ShixuanLiu9527/VUPRS-Support/fpga-support/tools/pic/image3.png

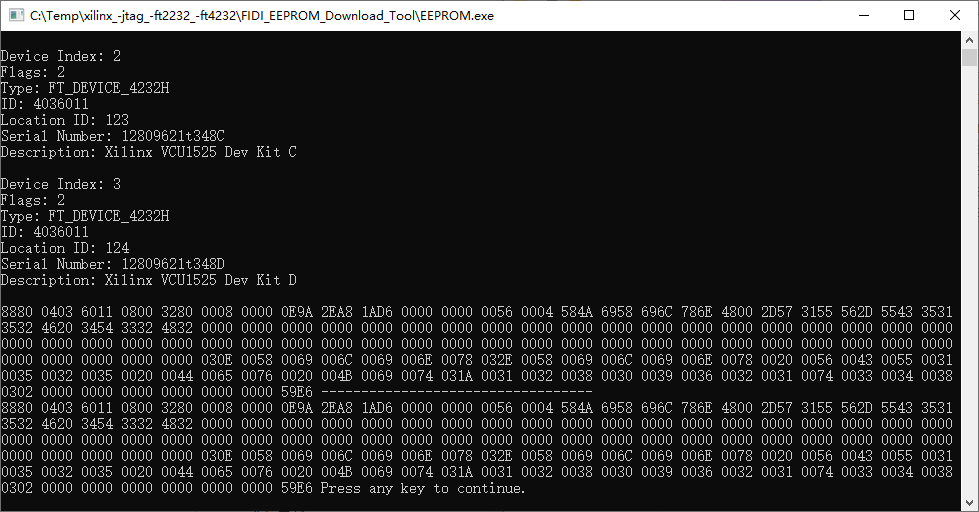
fpga-support/tools/pic/image3.png
