ShixuanLiu9527/VUPRS-Support/doc/VUPRS-Schematic.pdf

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
# Revision History

Version | Date | Author | Dsecription
V1.0 | 2025-5-15 | Shixuan Liu | First confirmation, some resistors & capacitors have been reserved.
V1.1 | 2025-7-13 | Shixuan Liu | Circuit inspection completed.

# 6223-UUD USB2 HOST3

# Debug

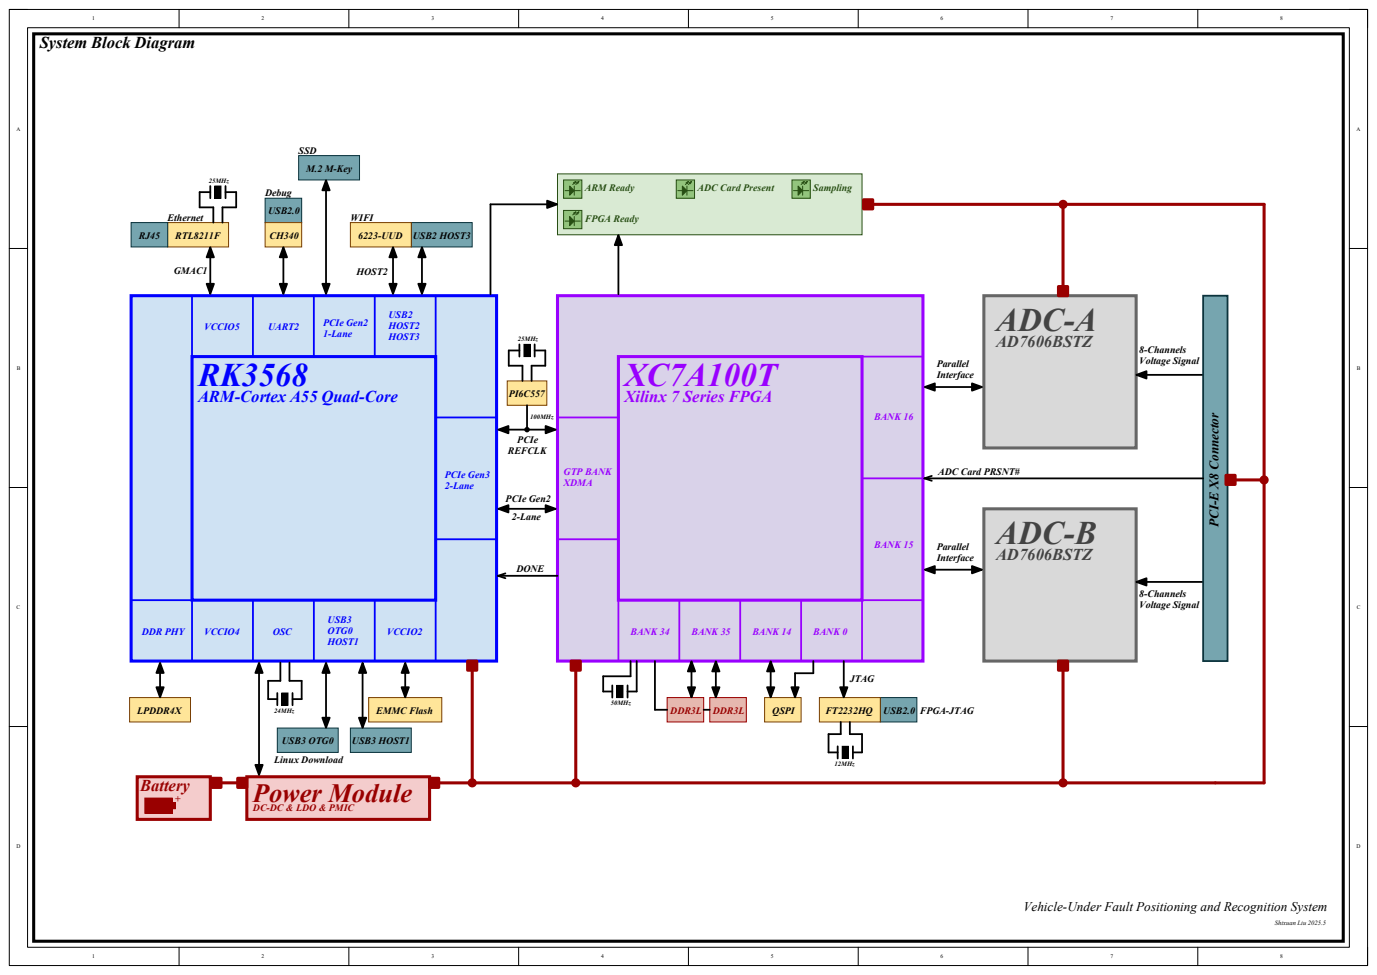
[picture p16: page 2]
ARM-Cortex A55 Quad-Core; Xilinx 7 Series FPGA; PCIe Gen3 2-Lane; GTP BANK XDMA; BANK 34; 2-Lane; Parallel Interface; BANK 16; PCIe Gen2; BANK 35; DDR3L DDR3L; 50MHz; BANK 14; BANK 0; QSPI; JTAG; USB2.0; VCCIO2; EMMC Flash; OSC; 24MHz; USB3 OTG0 HOST1; USB3 OTG0; USB3 HOST1; Linux Download; USB2 HOST2 HOST3; VCCIO4; UART2; HOST2; WIFI; AD7606BSTZ; ADC-A; BANK 15; Parallel; ADC-B; Interface; 8-Channels Voltage Signal; PCIe Gen2 1-Lane; M.2 M-Key; SSD; 100MHz; ADC Card PRSNT#; PCI⁻E X⁸ Connector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

System Block Diagram

DC-DC & LDO & PMIC

Vehicle-Under Fault Positioning and Recognition System

# Power Tree - Digital Circuit

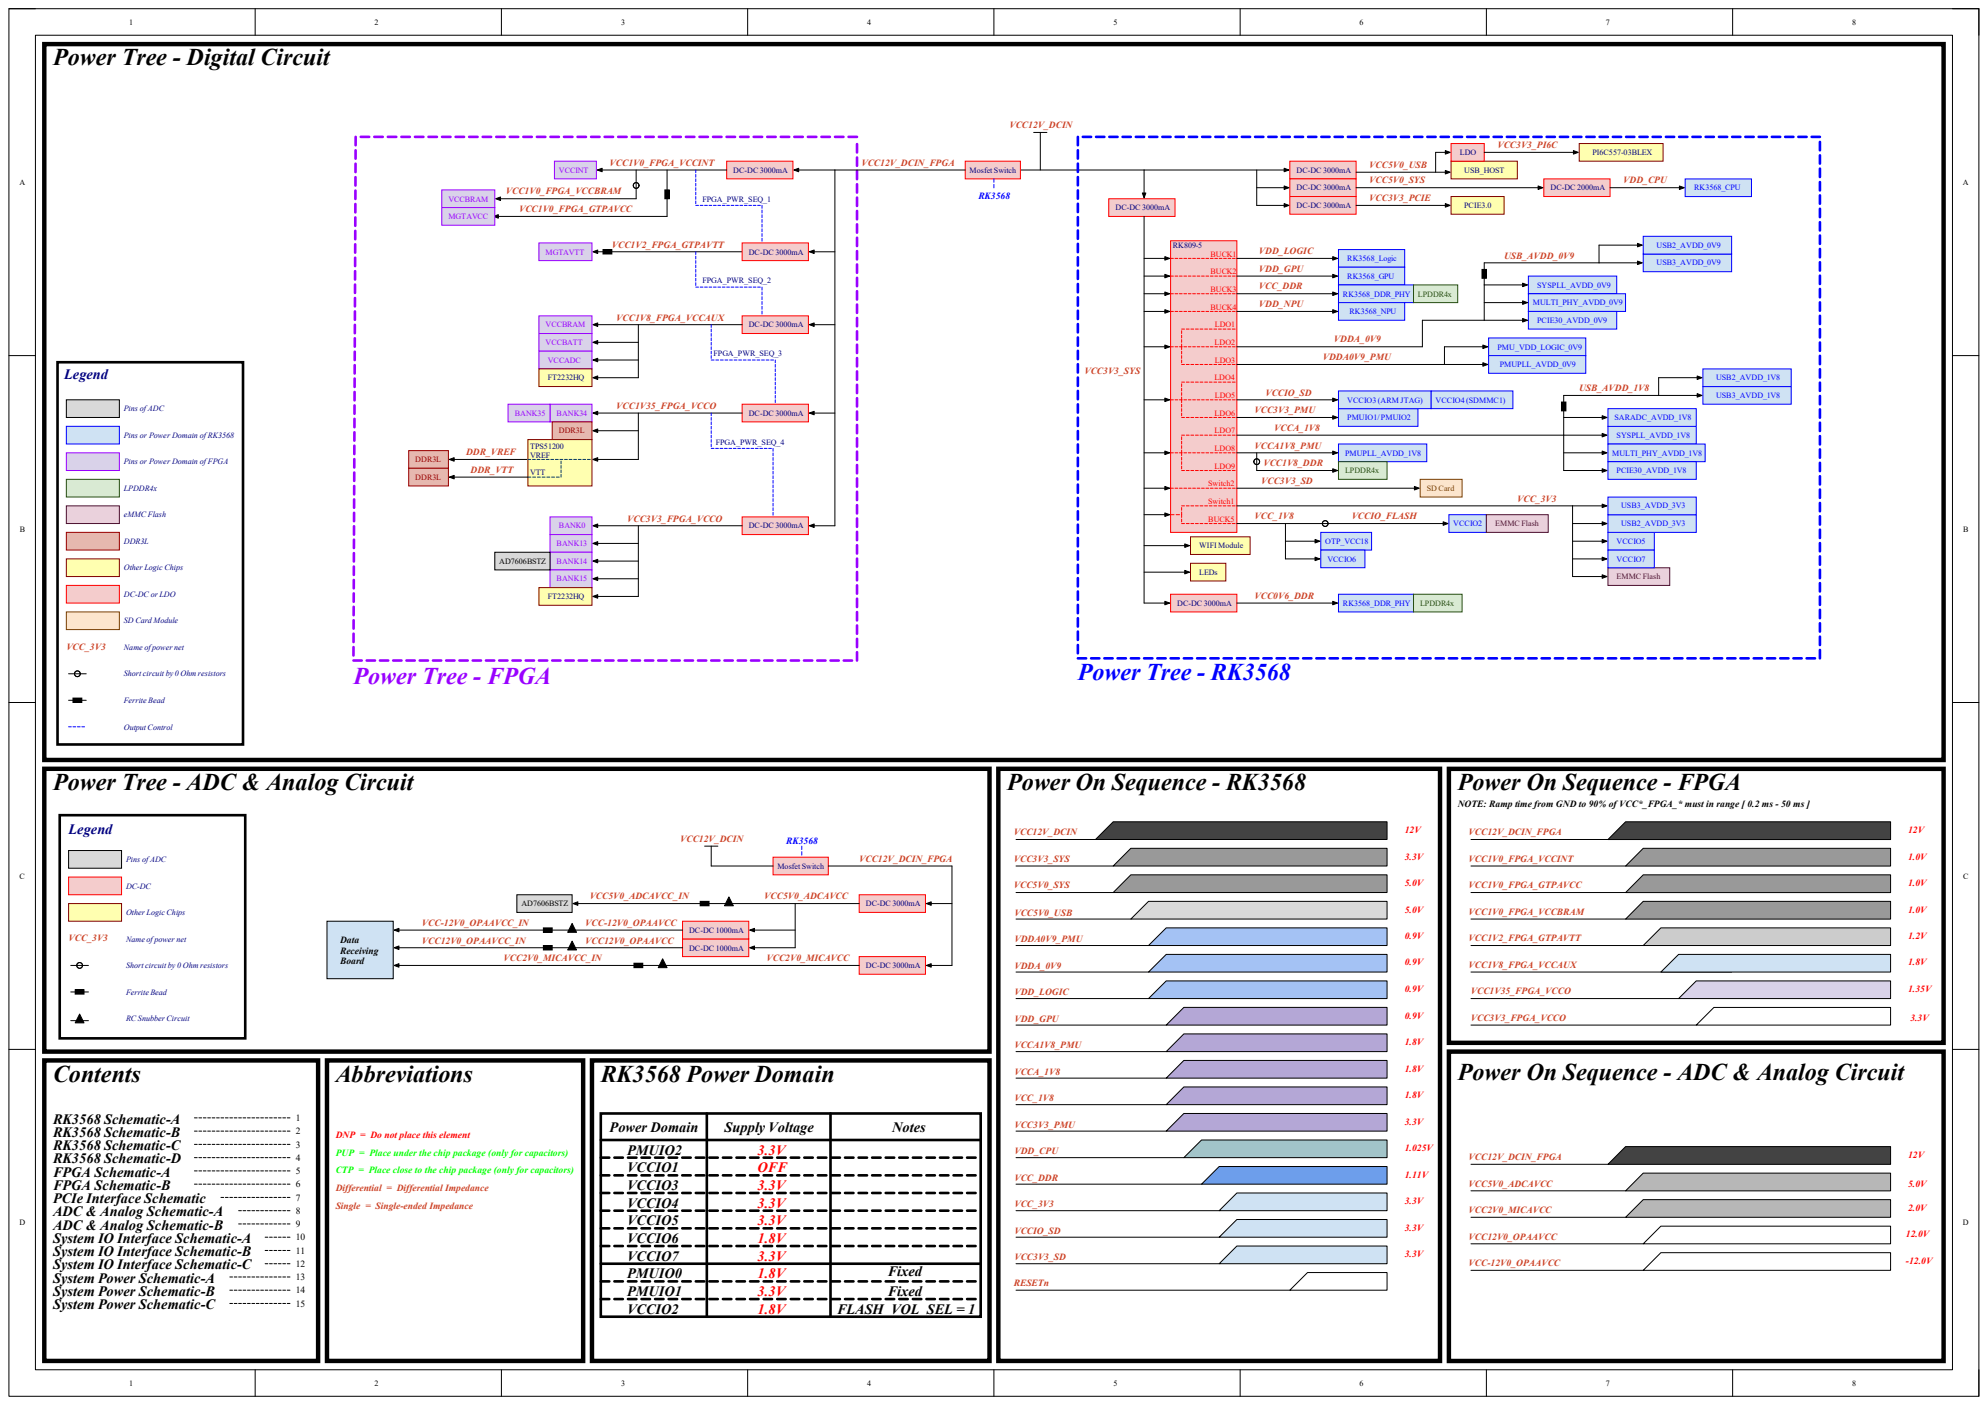
[picture p17: page 3]
VCC12V_DCIN; VCC5V0_USB; USB_HOST; VCC3V3_SYS; BUCK1; BUCK2; BUCK3; BUCK4; LDO1; Switch2; Switch1; BUCK5; LDO2; LDO3; LDO4; LDO5; LDO6; LDO7; LDO8; LDO9; RK3568_Logic; VDD_LOGIC; RK3568_GPU; VDD_GPU; RK3568_DDR_PHY; VCC_DDR; RK3568_NPU; VDD_NPU; VDDA_0V9; USB3_AVDD_0V9; USB2_AVDD_0V9; SYSPLL_AVDD_0V9; MULTI_PHY_AVDD_0V9; PCIE30_AVDD_0V9; VDDA0V9_PMU; PMU_VDD_LOGIC_0V9; PMUPLL_AVDD_0V9; PMUIO1/ PMUIO2; VCC3V3_PMU; USB3_AVDD_1V8; USB2_AVDD_1V8; SYSPLL_AVDD_1V8; MULTI_PHY_AVDD_1V8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

Pins of ADC

Pins or Power Domain of RK3568

Pins or Power Domain of FPGA

Other Logic Chips

DC-DC or LDO

SD Card Module

Short circuit by 0 Ohm resistors

Power On Sequence - RK3568

NOTE: Ramp time from GND to 90% of VCC*_FPGA_* must in range [ 0.2 ms - 50 ms ]

Power On Sequence - ADC & Analog Circuit

RC Snubber Circuit
Contents

RK3568 Schematic-A
RK3568 Schematic-B
RK3568 Schematic-C
RK3568 Schematic-D
FPGA Schematic-A
FPGA Schematic-B
PCIe Interface Schematic
ADC & Analog Schematic-A
ADC & Analog Schematic-B
System IO Interface Schematic-A
System IO Interface Schematic-B
System IO Interface Schematic-C
System Power Schematic-A

DNP = Do not place this element
PUP = Place under the chip package (only for capacitors)
CTP = Place close to the chip package (only for capacitors)
Differential = Differential Impedance
Single = Single-ended Impedance

System Power Schematic-B
System Power Schematic-C

# Impedence Template: JLC081611-1080

# TOP

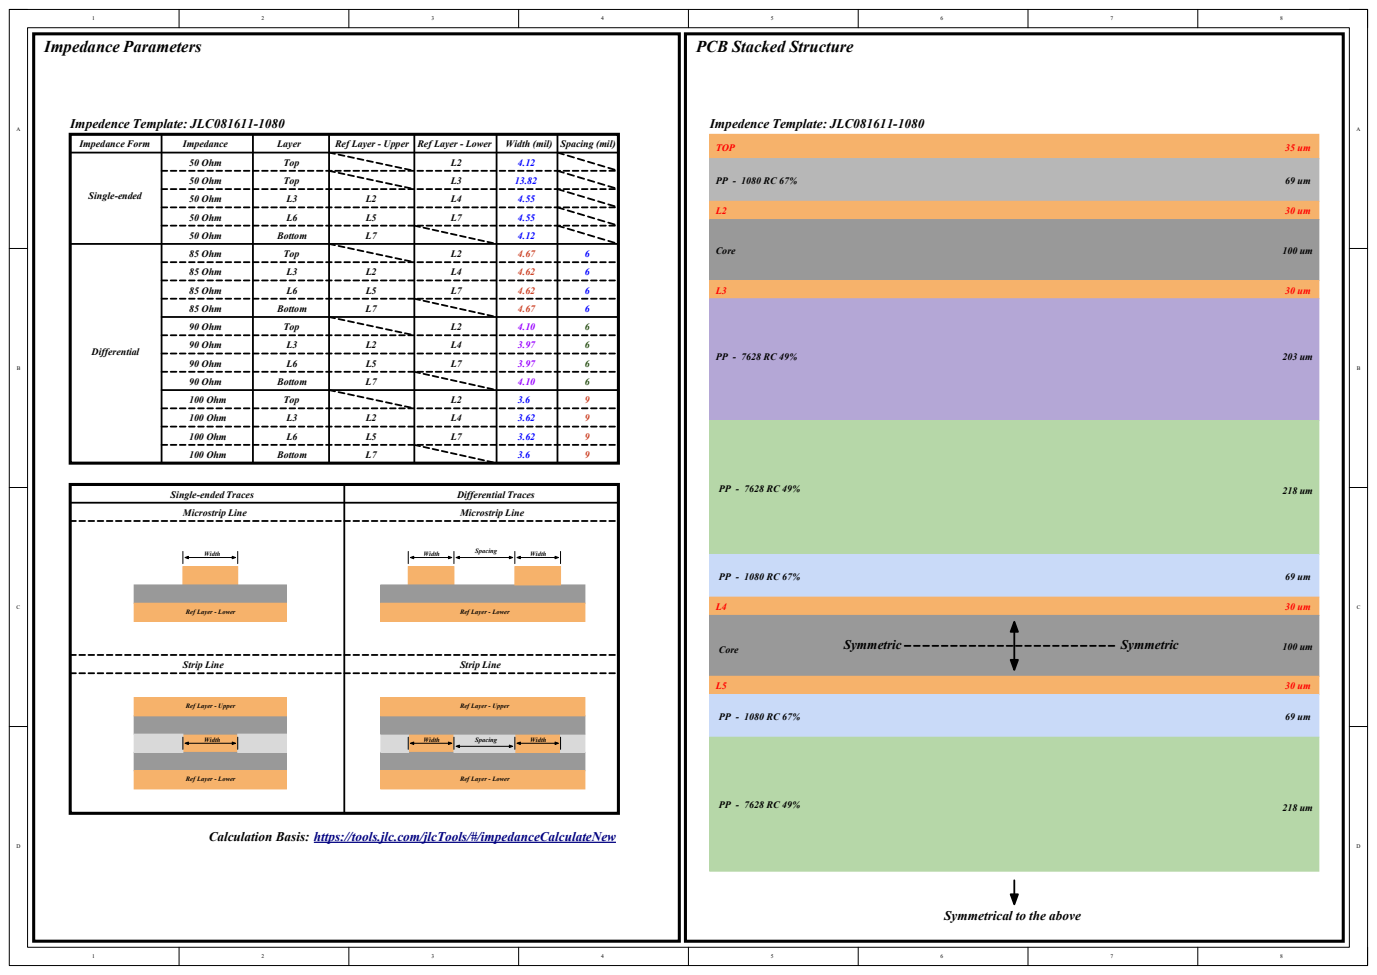
[picture p18: page 4]
Core; Symmetric; Impedance Form; Impedance; Layer; Ref Layer - Upper; Ref Layer - Lower; Width (mil); Spacing (mil); 50 Ohm; Top; Bottom; Single-ended; 85 Ohm; 90 Ohm; 100 Ohm; Differential; Single-ended Traces; Differential Traces; Microstrip Line; Strip Line; Width; Impedence Template: JLC081611-1080; Width Spacing; Spacing; Impedance Parameters; PCB Stacked Structure

Ref Layer - Lower

Ref Layer - Upper

Calculation Basis: https://tools.jlc.com/jlcTools/#/impedanceCalculateNew

Symmetrical to the above

# POWER

# Power & Gnd

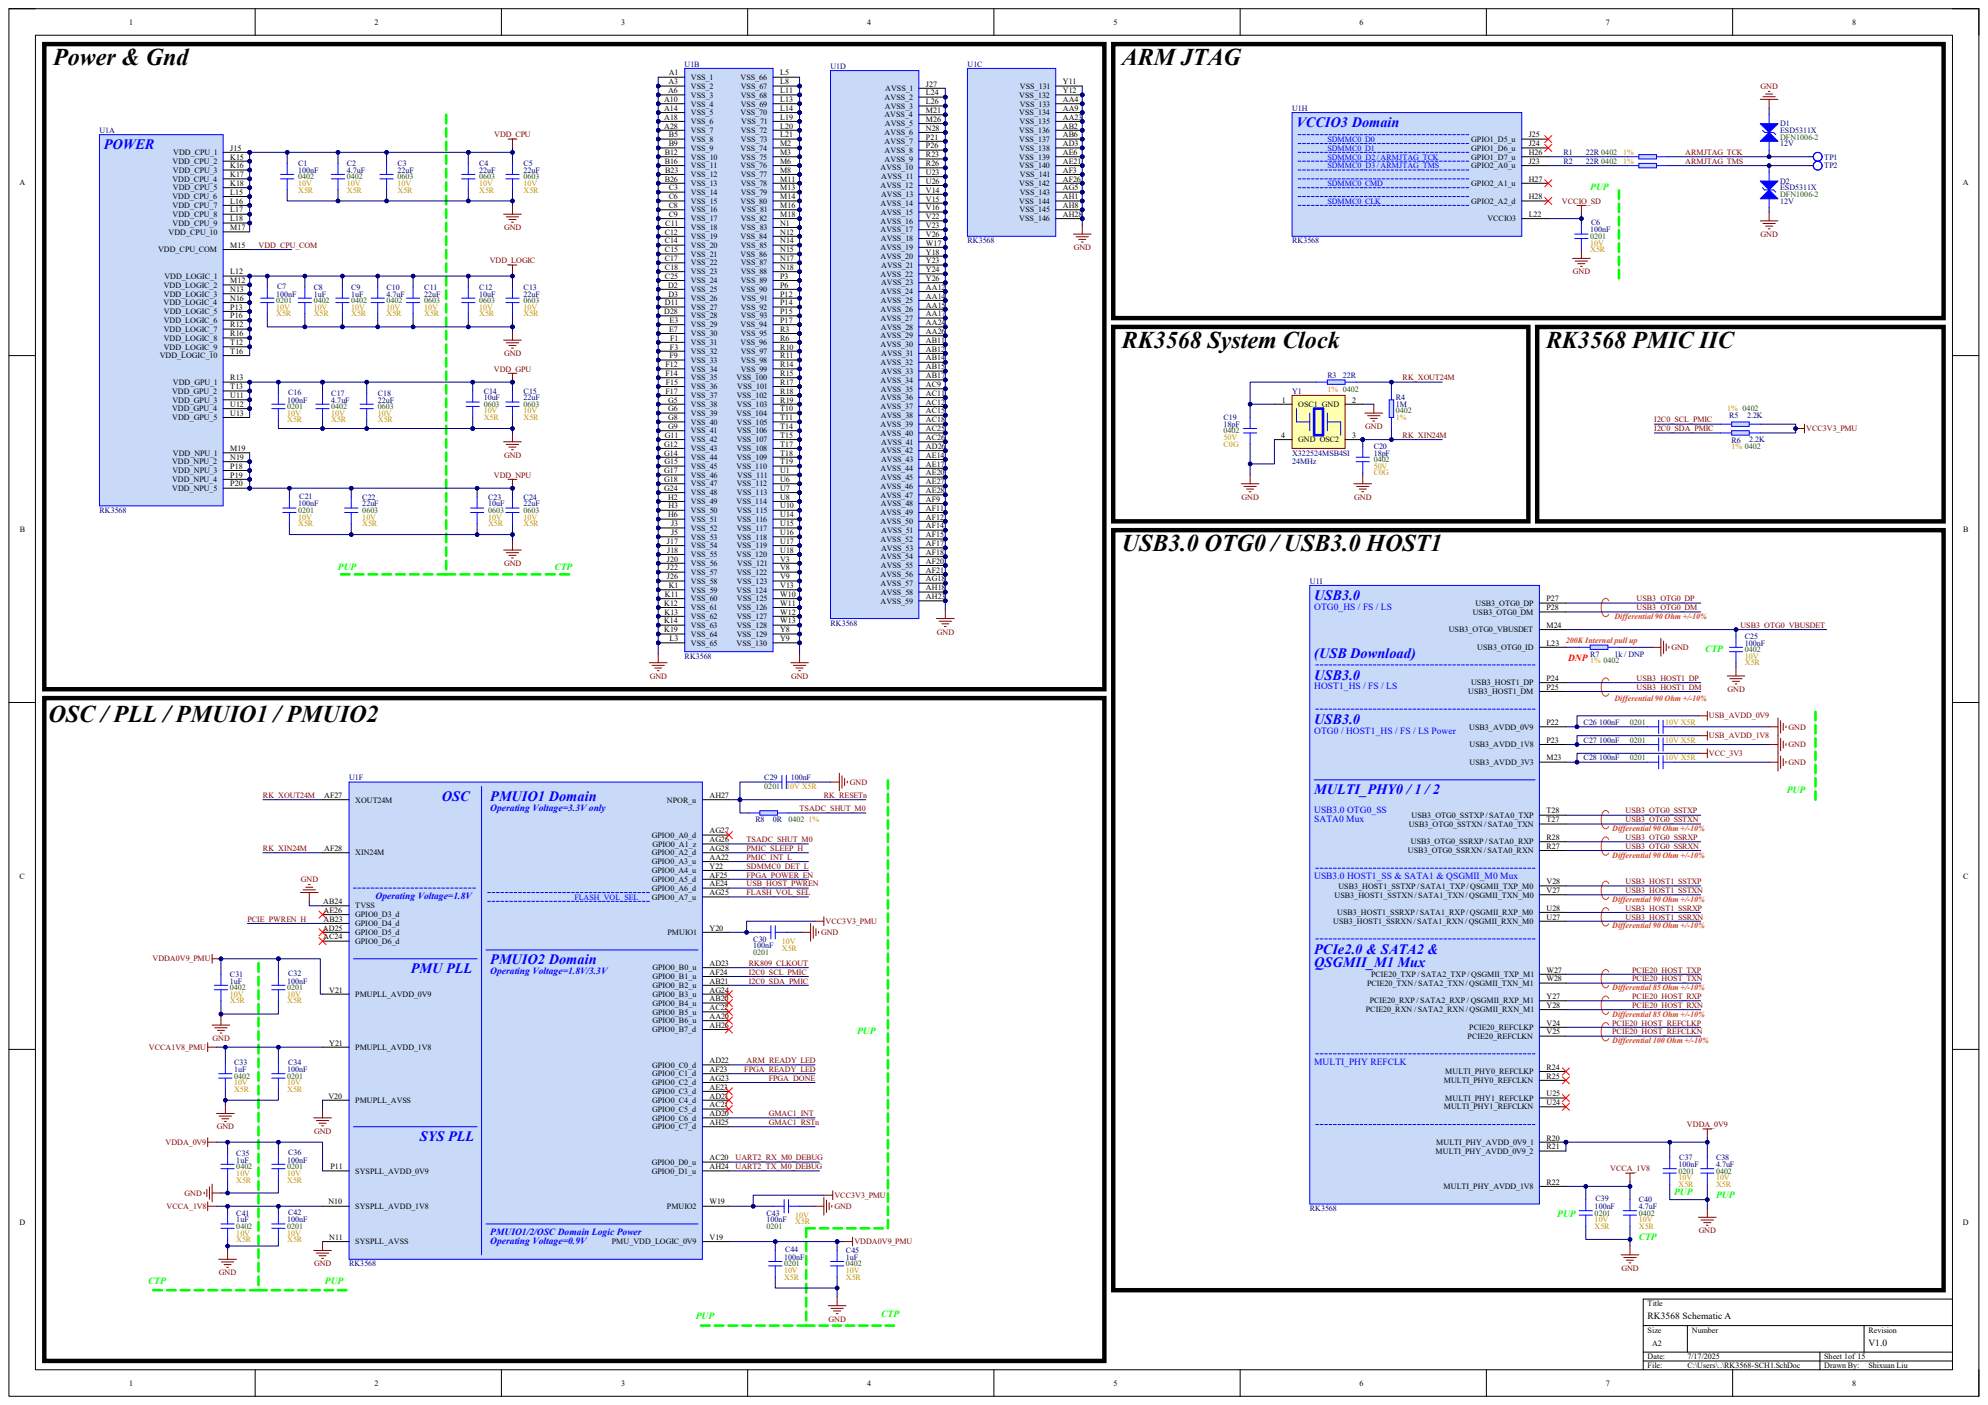
[picture p19: page 5]

PMUIO1/2/OSC Domain Logic Power
Operating Voltage=0.9V

# VCCIO2 Domain

# VCCIO4 Domain

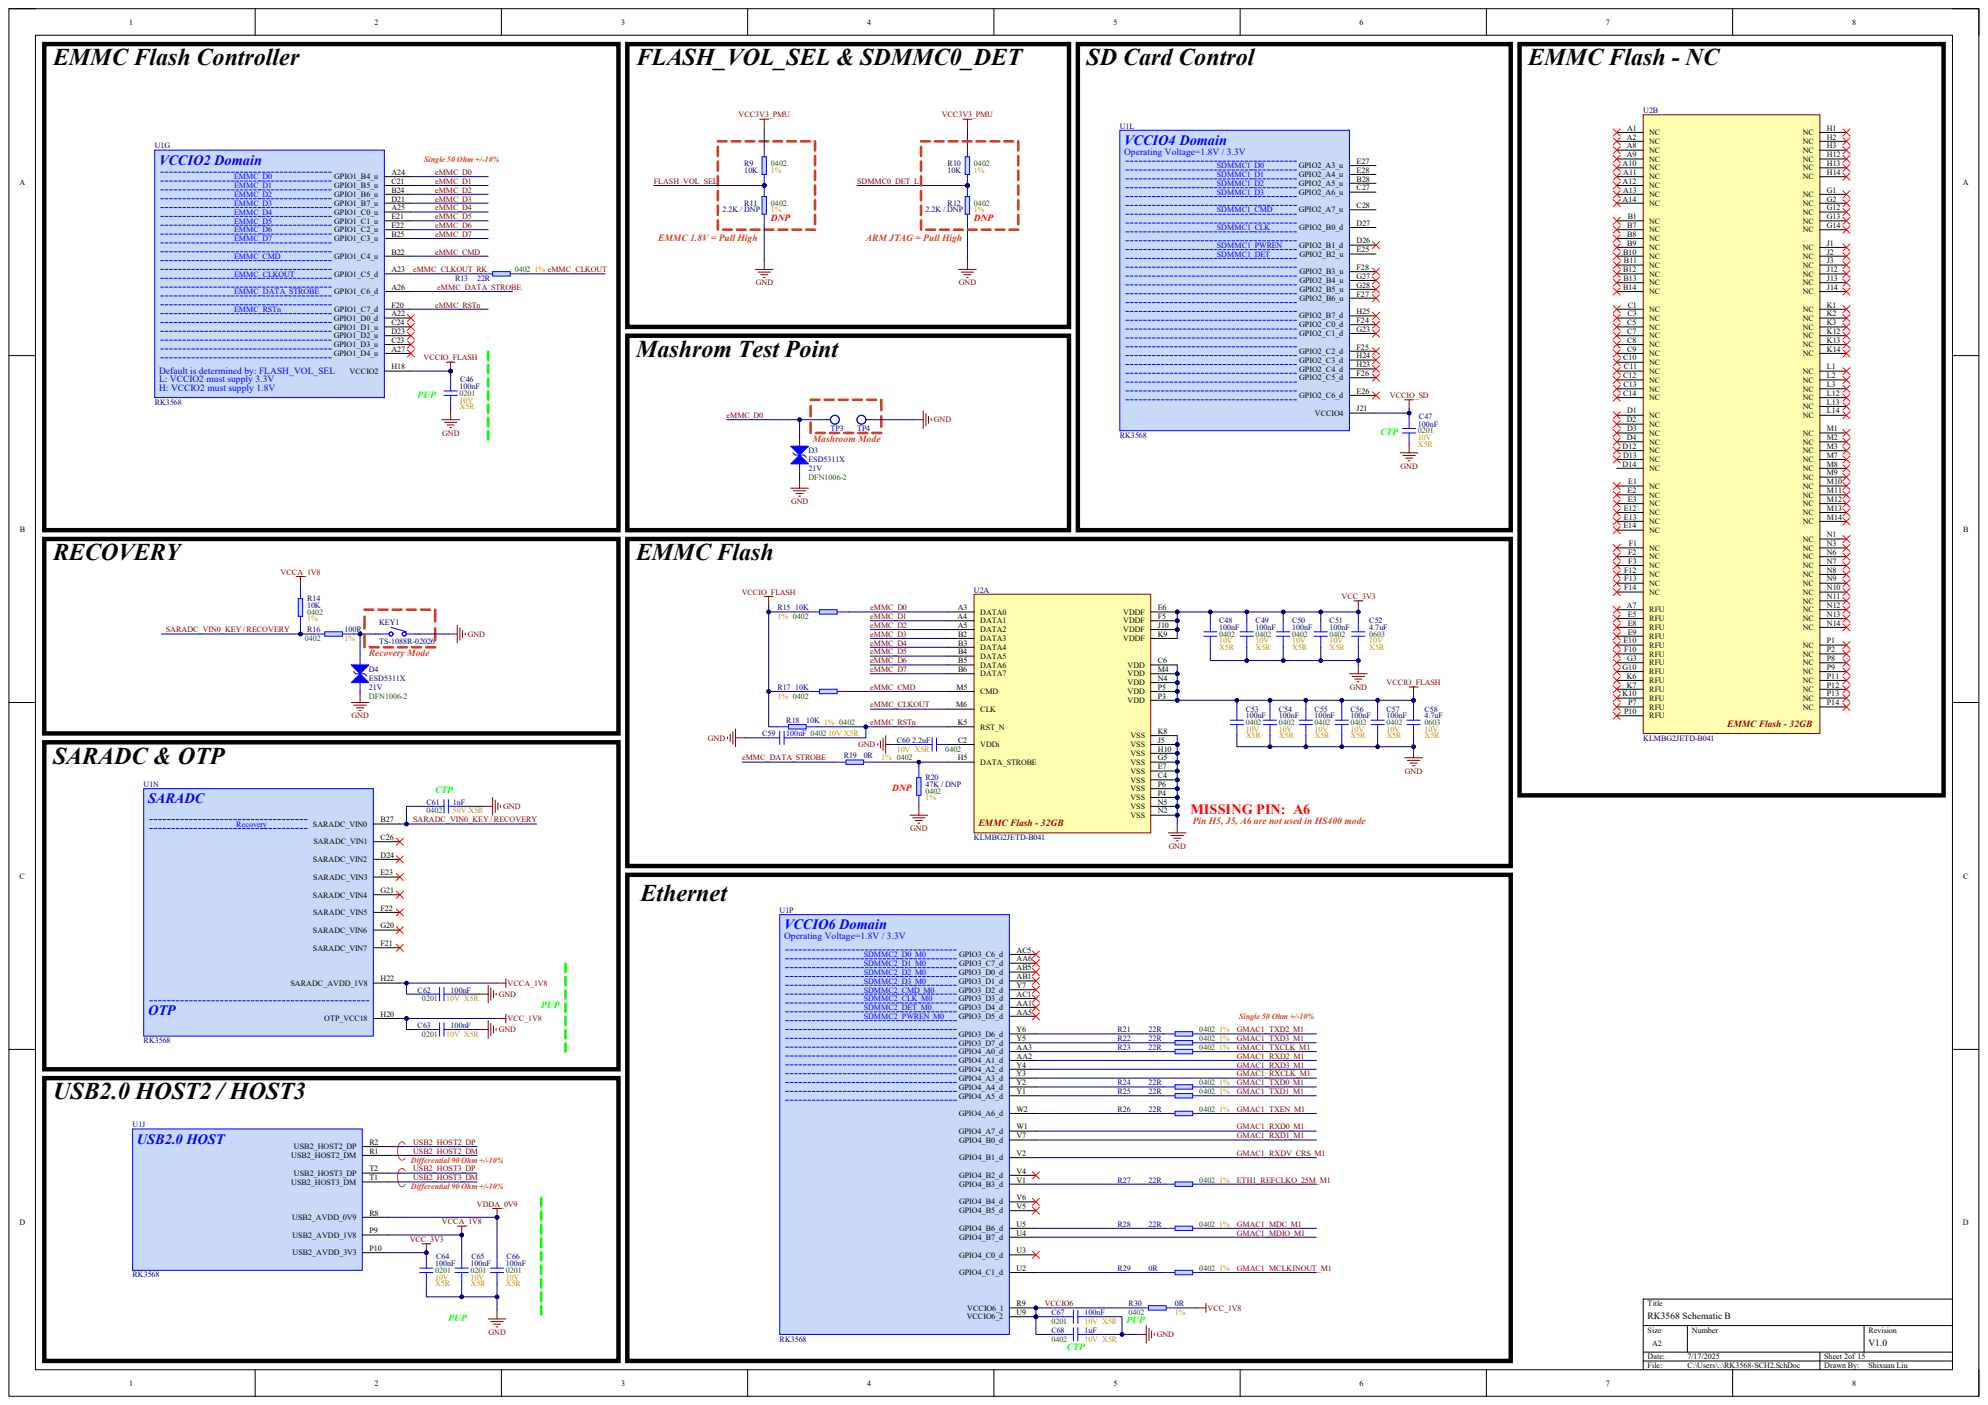
[picture p20: page 6]

ARM JTAG = Pull High

Default is determined by: FLASH_VOL_SEL
L: VCCIO2 must supply 3.3V
H: VCCIO2 must supply 1.8V

MISSING PIN: A6
Pin H5, J5, A6 are not used in HS400 mode

# DDR_ECC_DQS_N P1 Byte 0 Byte 1 Byte 3 Byte 2DDR_DQ8_B A16

# DDR PHY

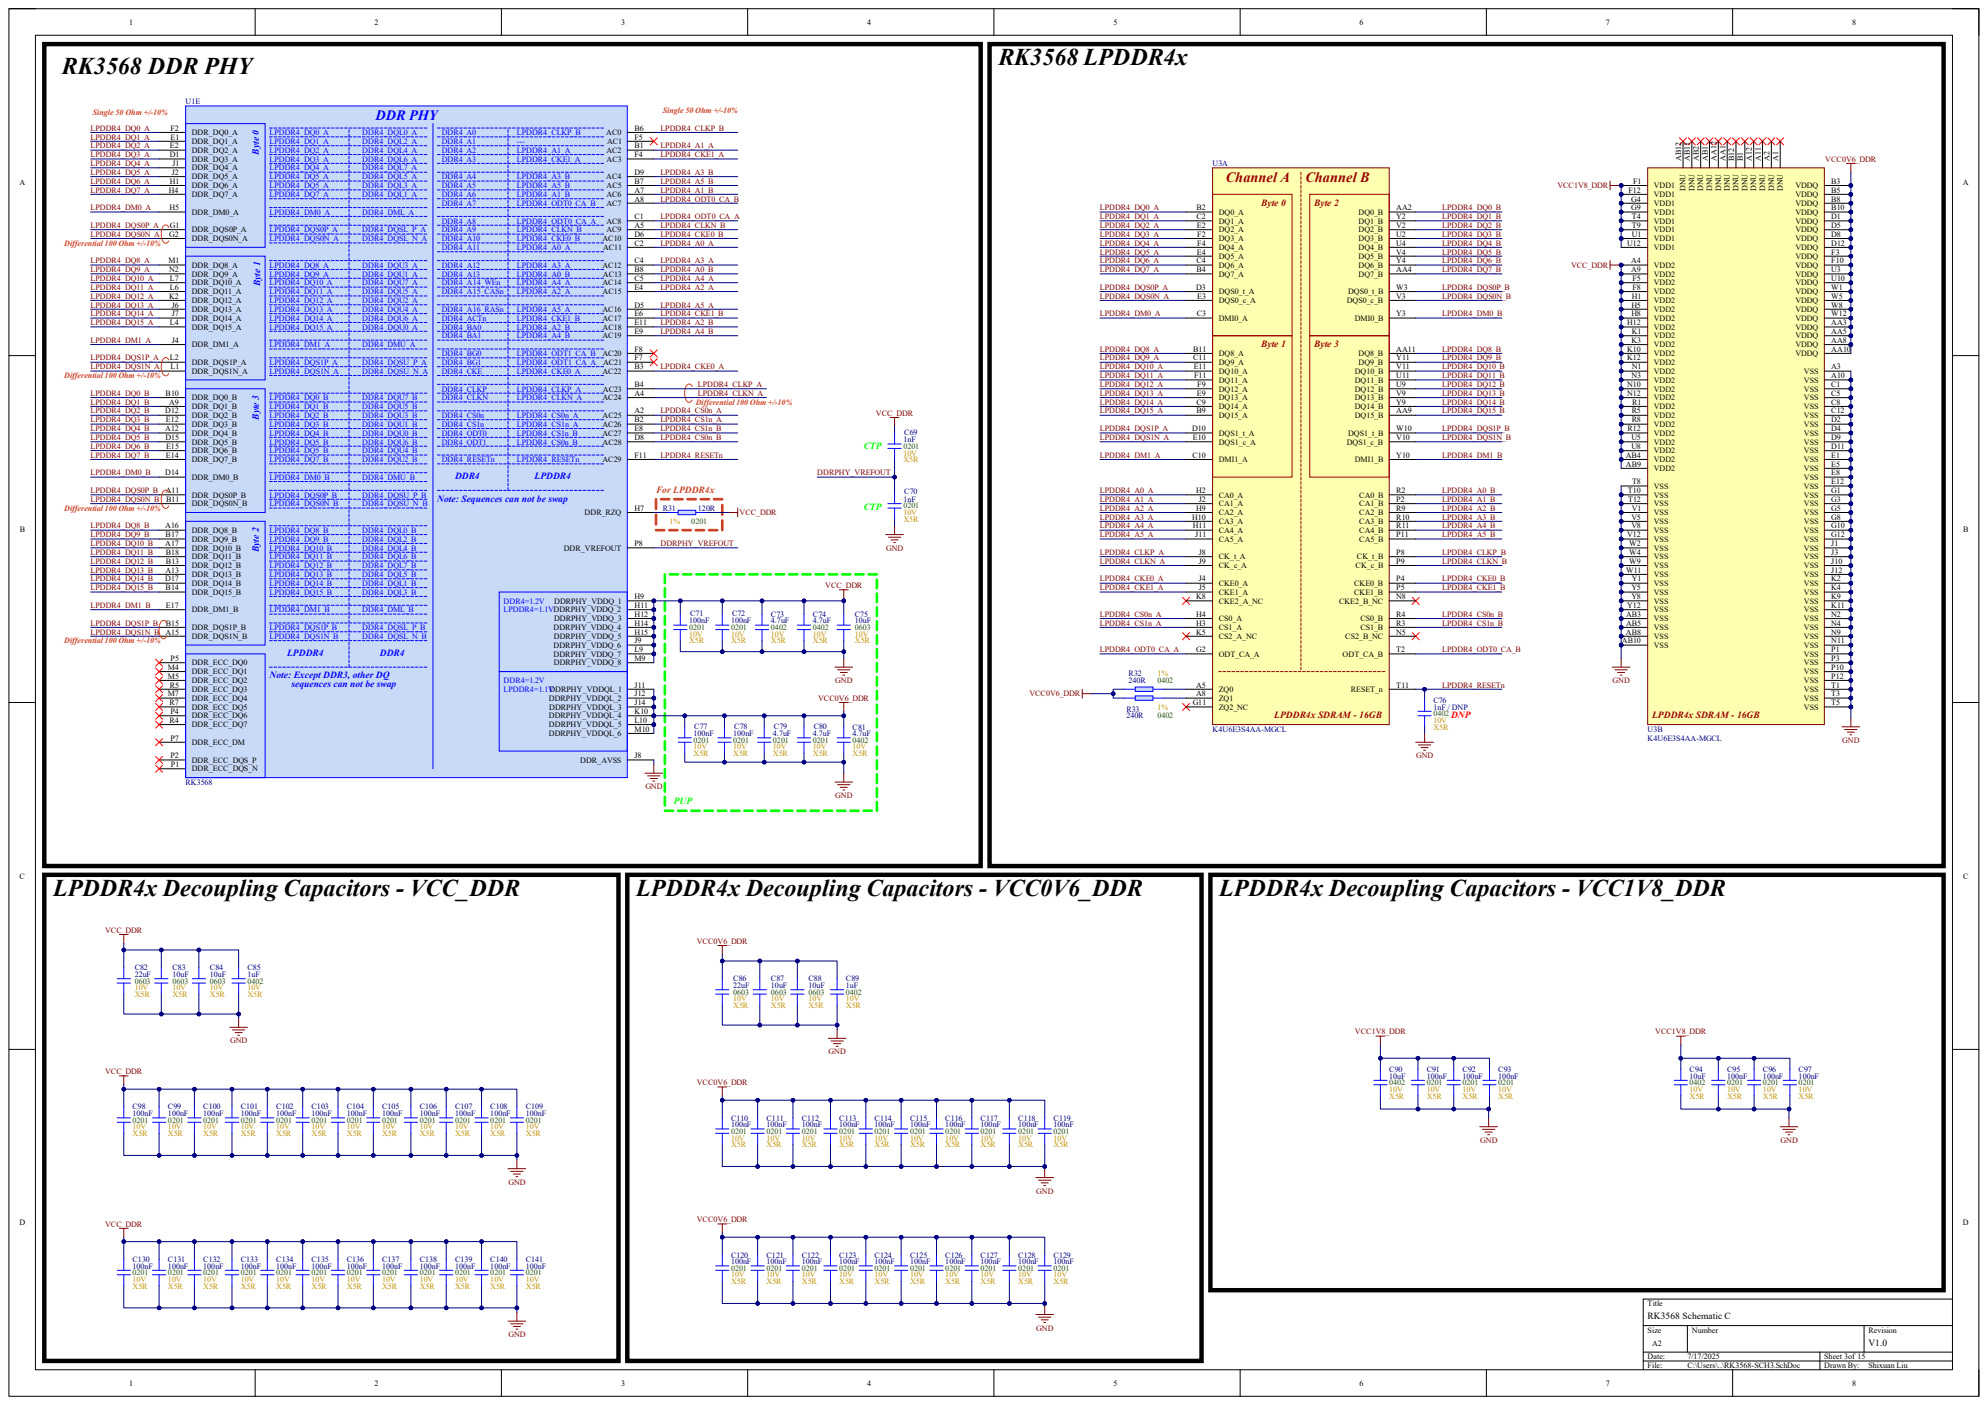
[picture p21: page 7]

T5 DNU A¹ DNU AB¹² DNU AB¹¹ DNU AB² DNU AB¹ DNU AA¹² DNU AA¹ DNU B¹² DNU B¹ DNU A¹² DNU A¹¹ DNU A²

Note: Sequences can not be swap

Note: Except DDR3, other DQ
sequences can not be swap

# MIPI CSI RX

# MIPI DSI TX0 / LVDS TX0

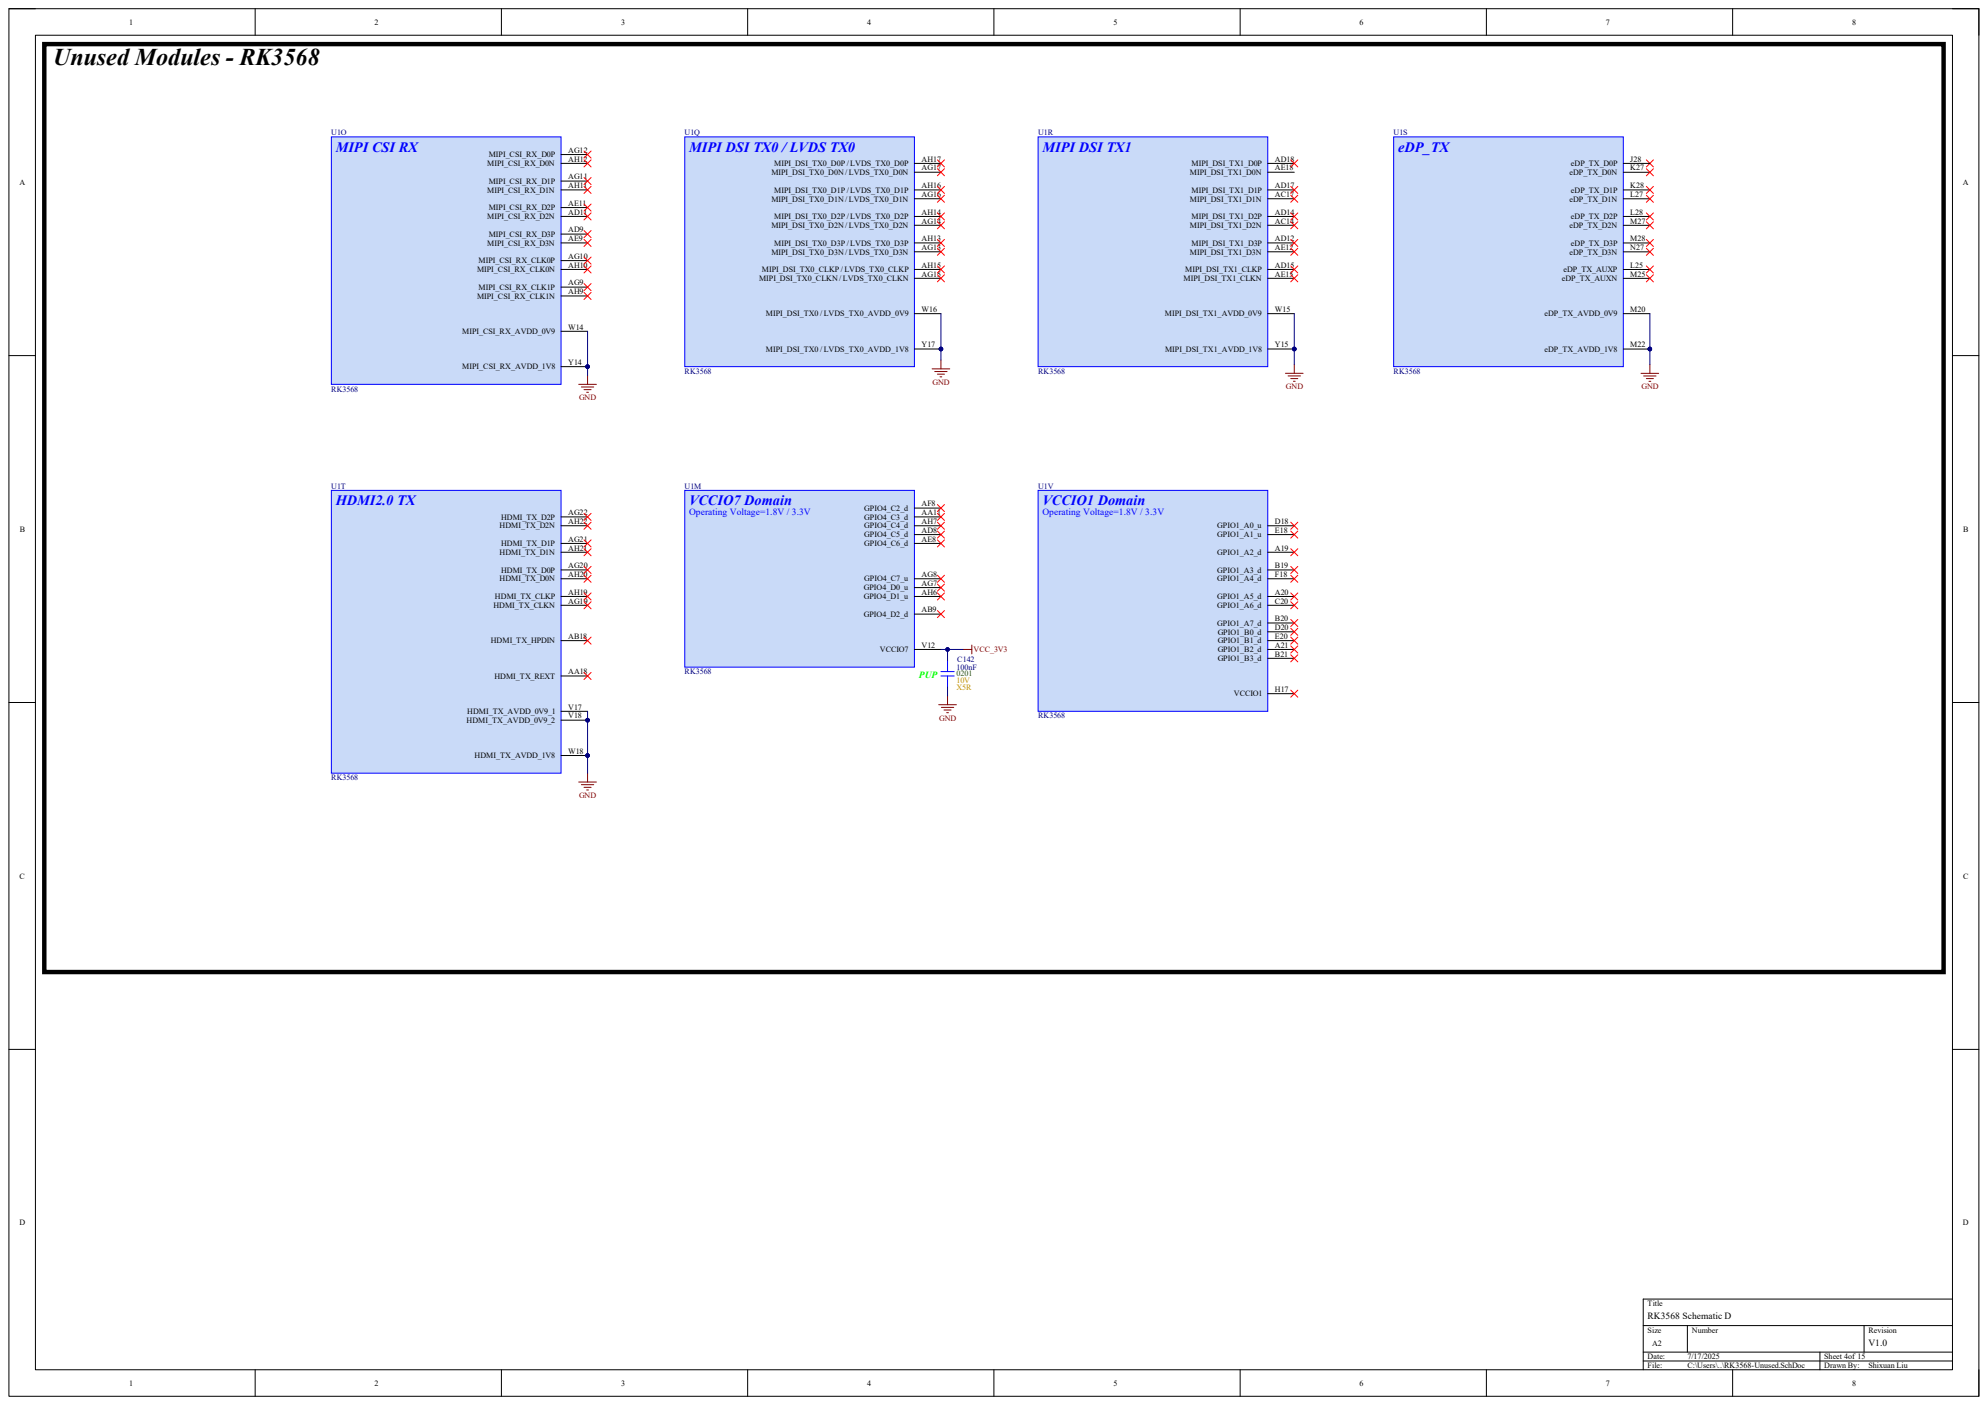
[picture p22: page 8]

# BANK 0

VCCINT | T10 VCCINT | T8 VCCINT | R9 VCCINT | R7 VCCINT | P10 VCCINT | P8 VCCINT | N7 VCCINT | M8 VCCINT | L7 VCCINT | K8 VCCINT | J9 VCCINT | J7 VCCINT | H10 VCCINT | H8

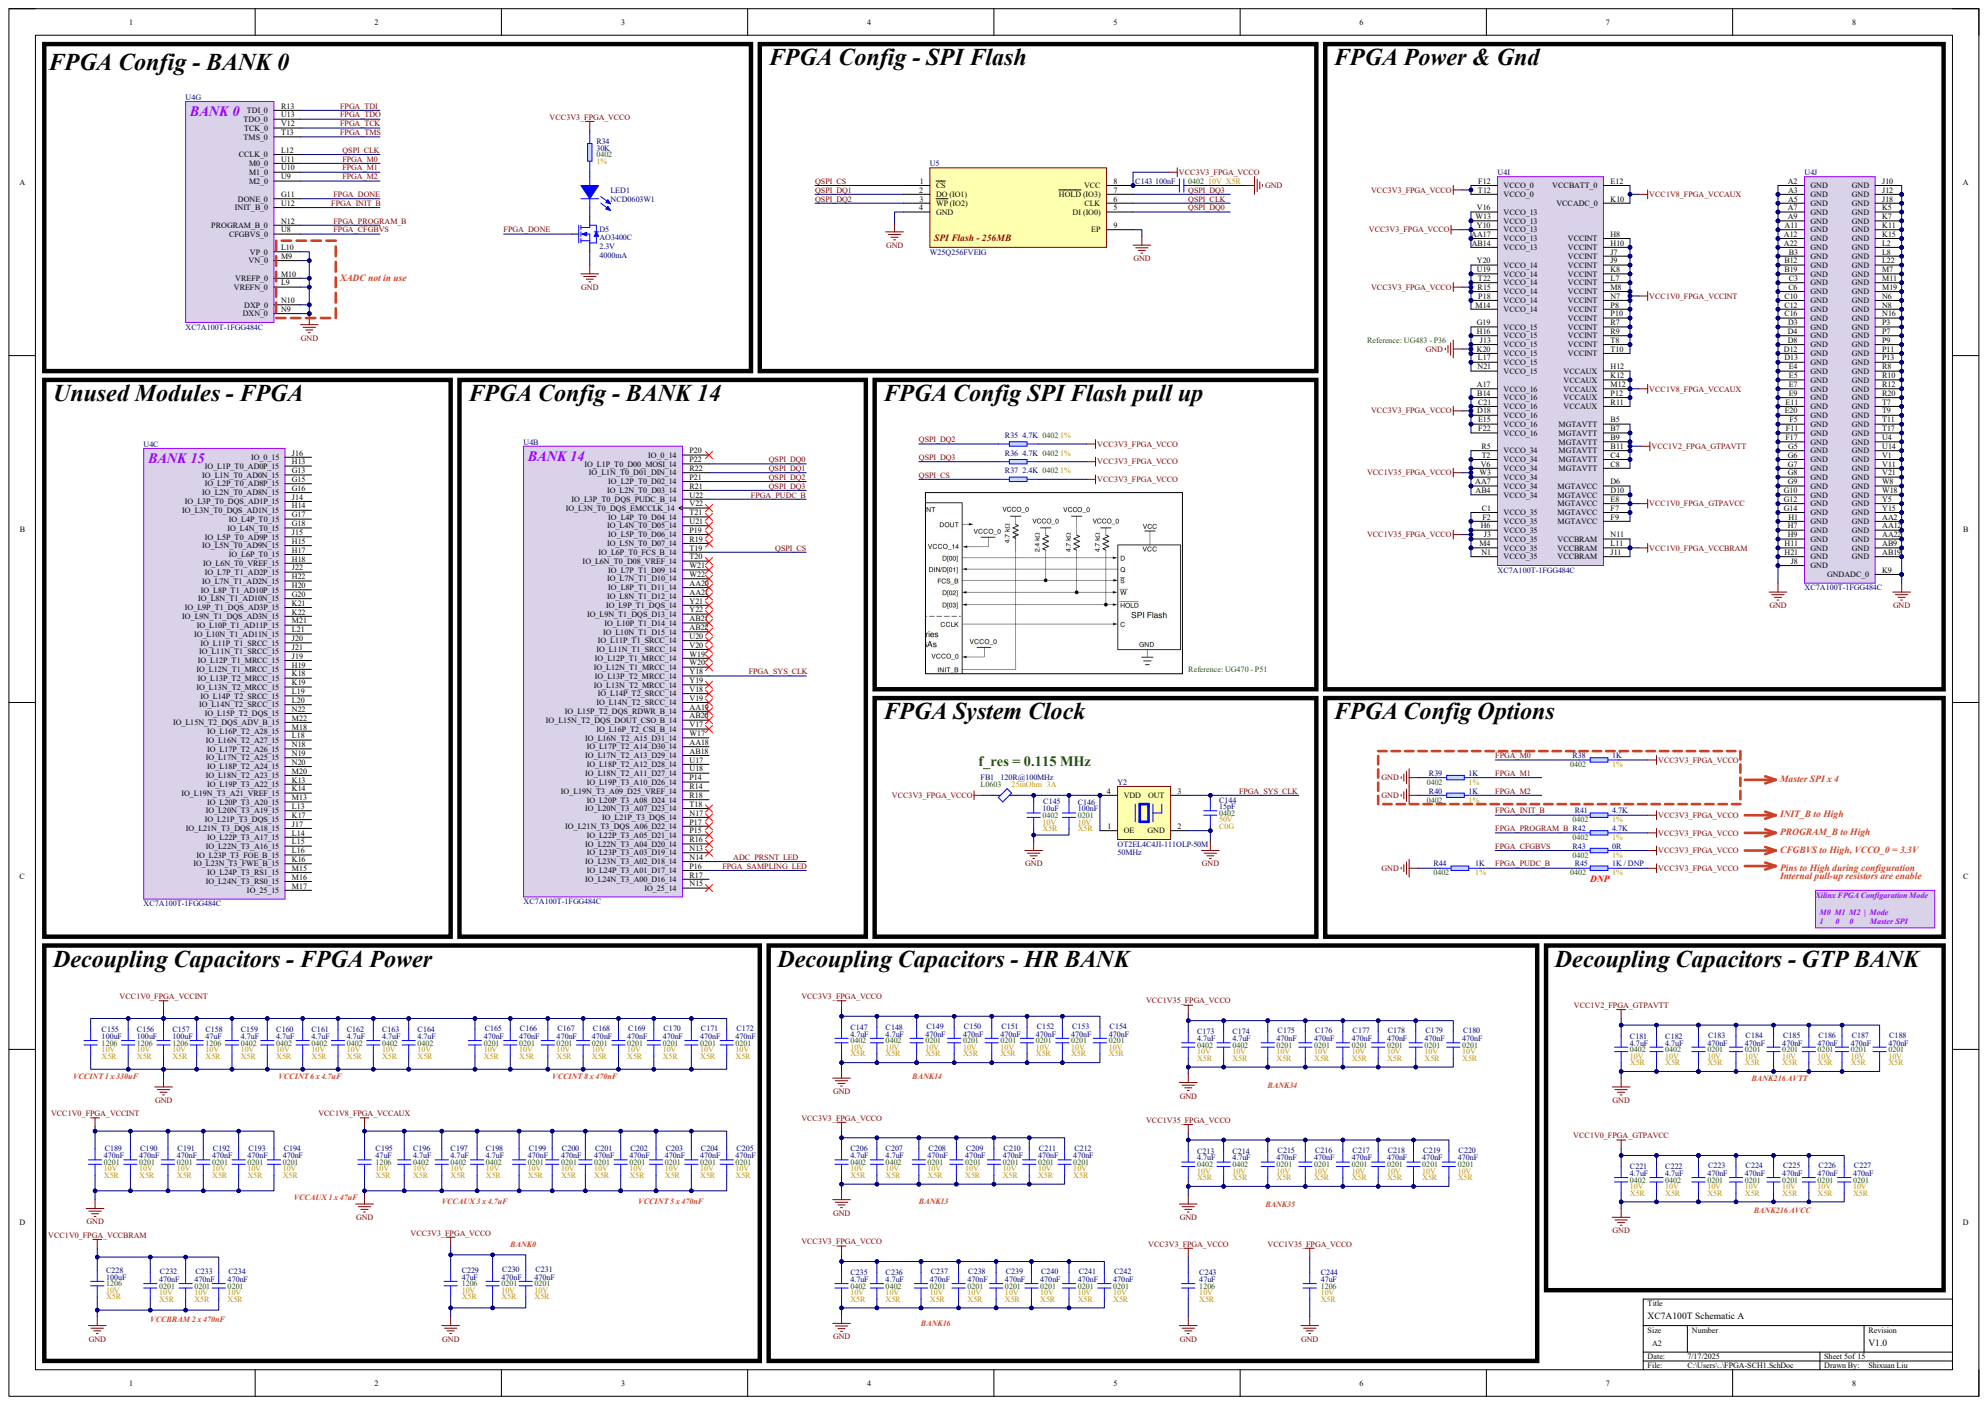
[picture p23: page 9]

FPGA Config - SPI Flash

XADC not in use

FPGA Config SPI Flash pull up

INIT_B to High
PROGRAM_B to High
CFGBVS to High, VCCO_0 = 3.3V
Pins to High during configuration

FPGA_CFGBVS
Internal pull-up resistors are enable ¹%

Xilinx FPGA Configaration Mode
M0 M1 M2 | Mode

Decoupling Capacitors - FPGA Power

IO_25_34 | U7 IO_L24N_T3_34 | Y9 IO_L24P_T3_34 | W9 IO_L23N_T3_34 | Y7 IO_L23P_T3_34 | Y8 IO_L22N_T3_34 | AB8 IO_L22P_T3_34 | AA8 IO_L21N_T3_DQS_34 | V8 IO_L21P_T3_DQS_34 | V9 IO_L20N_T3_34 | AB6 IO_L20P_T3_34 | AB7 IO_L19N_T3_VREF_34 | W7 IO_L19P_T3_34 | V7 IO_L18N_T2_34 | AA6 IO_L18P_T2_34 | Y6 IO_L17N_T2_34 | T6 IO_L17P_T2_34 | R6 IO_L16N_T2_34 | V5 IO_L16P_T2_34 | U6 IO_L15N_T2_DQS_34 | W5 IO_L15P_T2_DQS_34 | W6 IO_L14N_T2_SRCC_34 | U5 IO_L14P_T2_SRCC_34 | T5 IO_L13N_T2_MRCC_34 | T4 IO_L13P_T2_MRCC_34 | R4 IO_L12N_T1_MRCC_34 | W4 IO_L12P_T1_MRCC_34 | V4 IO_L11N_T1_SRCC_34 | AA4 IO_L11P_T1_SRCC_34 | Y4 IO_L10N_T1_34 | AB5 IO_L10P_T1_34 | AA5 IO_L9N_T1_DQS_34 | AA3 IO_L9P_T1_DQS_34 | Y3 IO_L8N_T1_34 | AB2 IO_L8P_T1_34 | AB3 IO_L7N_T1_34 | AB1 IO_L7P_T1_34 | AA1 IO_L6N_T0_VREF_34 | V3 IO_L6P_T0_34 | U3 IO_L5N_T0_34 | Y1 IO_L5P_T0_34 | W1 IO_L4N_T0_34 | Y2 IO_L4P_T0_34 | W2 IO_L3N_T0_DQS_34 | R2 IO_L3P_T0_DQS_34 | R3 IO_L2N_T0_34 | V2 IO_L2P_T0_34 | U2 IO_L1N_T0_34 | U1 IO_L1P_T0_34 | T1 IO_0_34 | T3 BANK 34
IO_25_35 | L6 IO_L24N_T3_35 | N5 IO_L24P_T3_35 | P6 IO_L23N_T3_35 | M5 IO_L23P_T3_35 | M6 IO_L22N_T3_35 | N2 IO_L22P_T3_35 | P2 IO_L21N_T3_DQS_35 | P4 IO_L21P_T3_DQS_35 | P5 IO_L20N_T3_35 | P1 IO_L20P_T3_35 | R1 IO_L19N_T3_VREF_35 | N3 IO_L19P_T3_35 | N4 IO_L18N_T2_35 | L4 IO_L18P_T2_35 | L5 IO_L17N_T2_35 | J6 IO_L17P_T2_35 | K6 IO_L16N_T2_35 | M2 IO_L16P_T2_35 | M3 IO_L15N_T2_DQS_35 | L1 IO_L15P_T2_DQS_35 | M1 IO_L14N_T2_SRCC_35 | K3 IO_L14P_T2_SRCC_35 | L3 IO_L13N_T2_MRCC_35 | J4 IO_L13P_T2_MRCC_35 | K4 IO_L12N_T1_MRCC_35 | G4 IO_L12P_T1_MRCC_35 | H4 IO_L11N_T1_SRCC_35 | G3 IO_L11P_T1_SRCC_35 | H3 IO_L10N_T1_AD15N_35 | H5 IO_L10P_T1_AD15P_35 | J5 IO_L9N_T1_DQS_AD7N_35 | J2 IO_L9P_T1_DQS_AD7P_35 | K2 IO_L8N_T1_AD14N_35 | G2 IO_L8P_T1_AD14P_35 | H2 IO_L7N_T1_AD6N_35 | J1 IO_L7P_T1_AD6P_35 | K1 IO_L6N_T0_VREF_35 | E3 IO_L6P_T0_35 | F3 IO_L5N_T0_AD13N_35 | F1 IO_L5P_T0_AD13P_35 | G1 IO_L4N_T0_35 | D2 IO_L4P_T0_35 | E2 IO_L3N_T0_DQS_AD5N_35 | D1 IO_L3P_T0_DQS_AD5P_35 | E1 IO_L2N_T0_AD12N_35 | B2 IO_L2P_T0_AD12P_35 | C2 IO_L1N_T0_AD4N_35 | A1 IO_L1P_T0_AD4P_35 | B1 IO_0_35 | F4 BANK 35

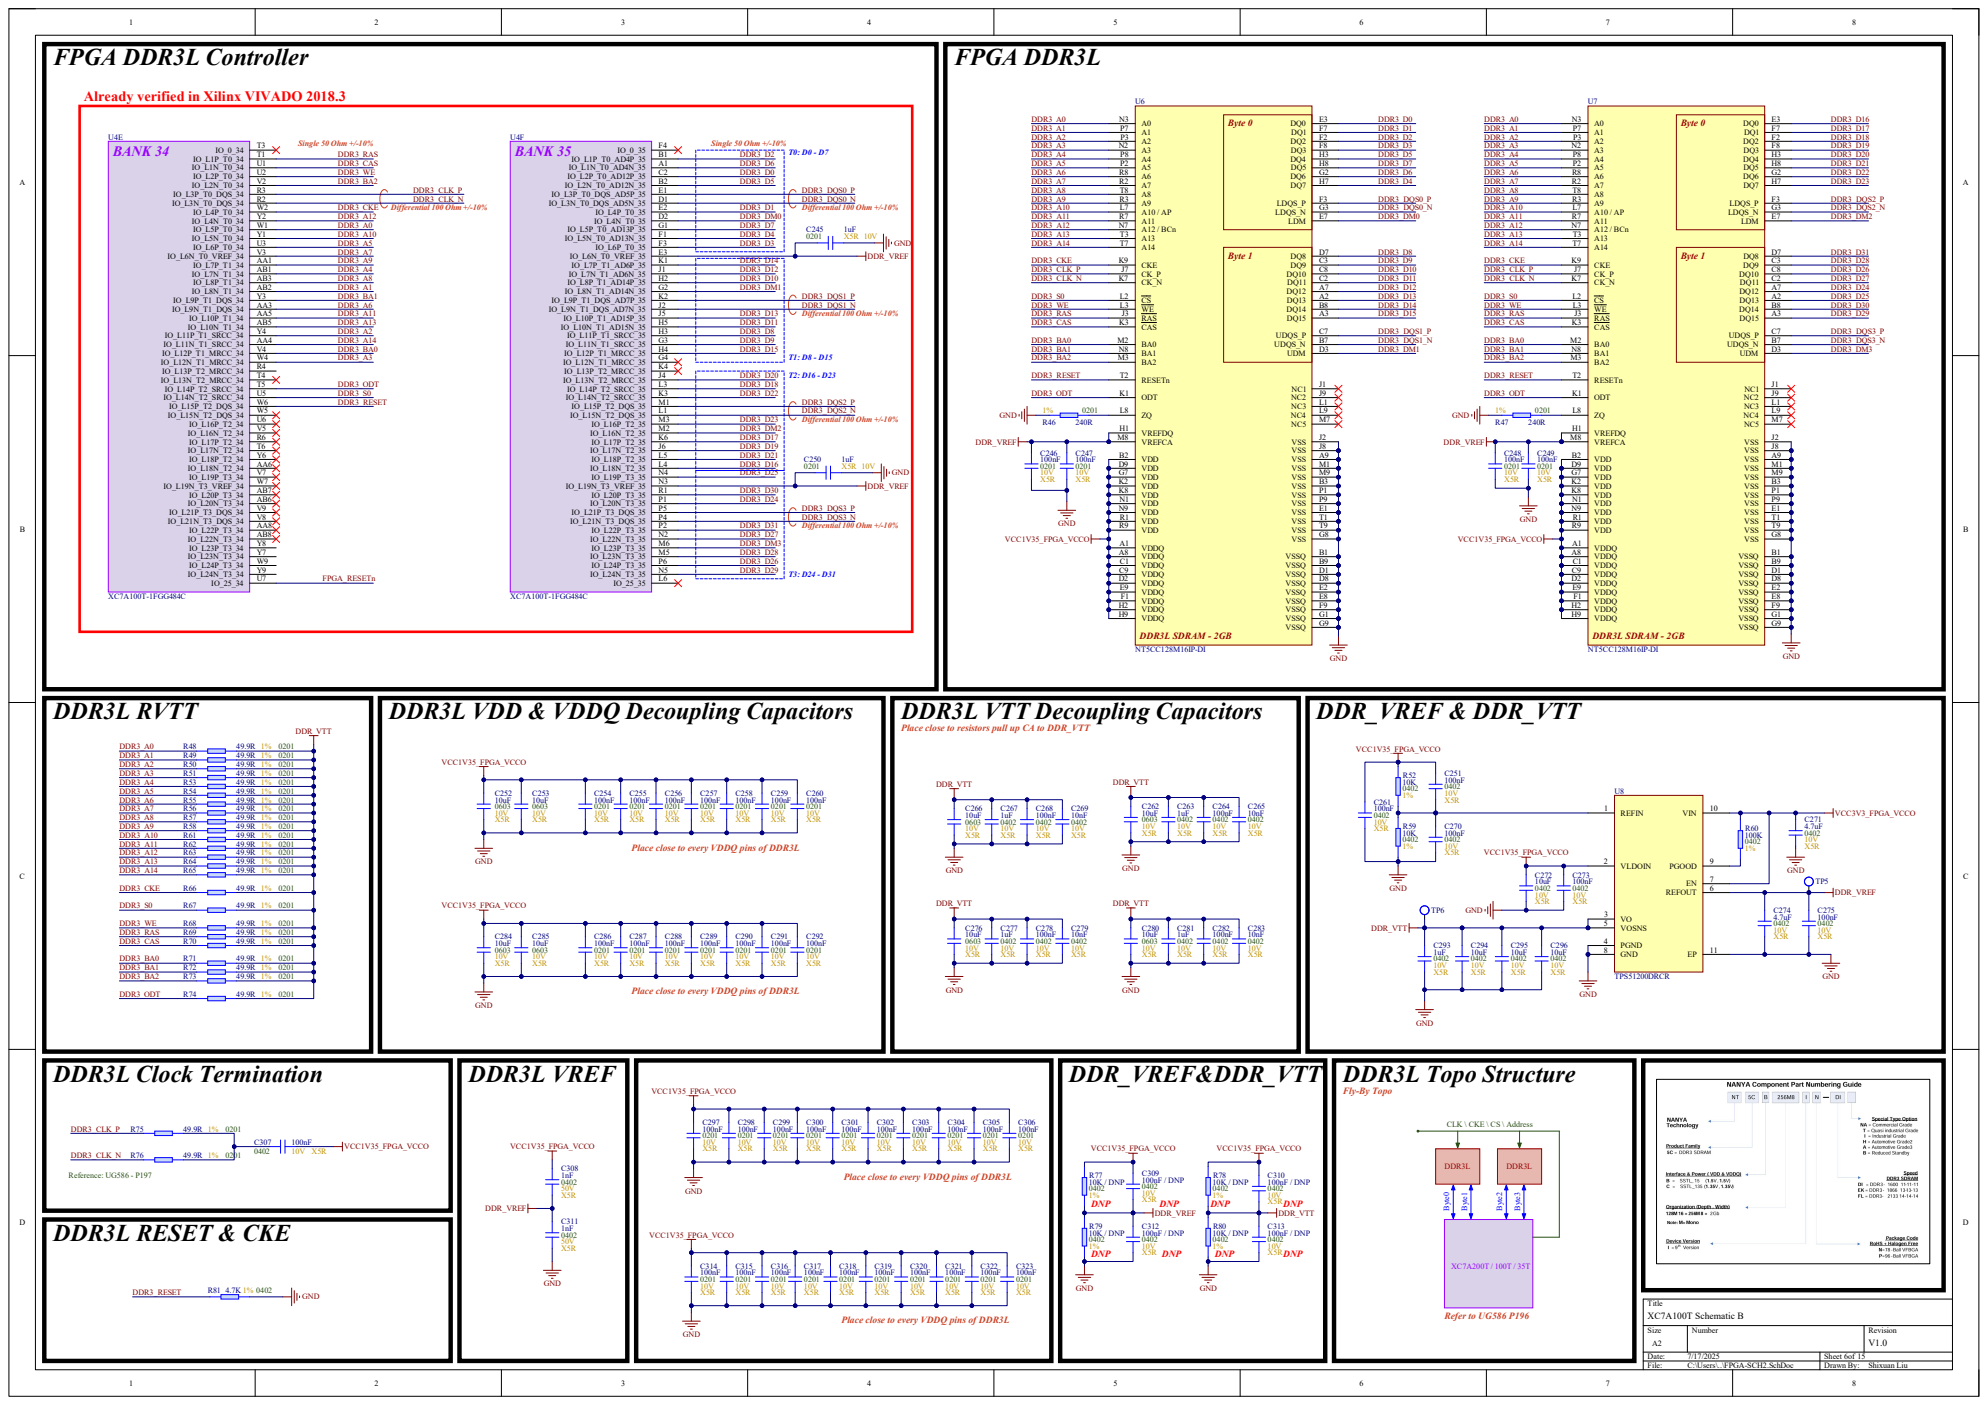
[picture p24: page 10]

Already verified in Xilinx VIVADO 2018.3

DDR3L VDD & VDDQ Decoupling Capacitors

Place close to resistors pull up CA to DDR_VTT

Place close to every VDDQ pins of DDR3L

CLK \ CKE \ CS \ Address

# PCIe3.0 x 2

# PCIe3.0 Interface

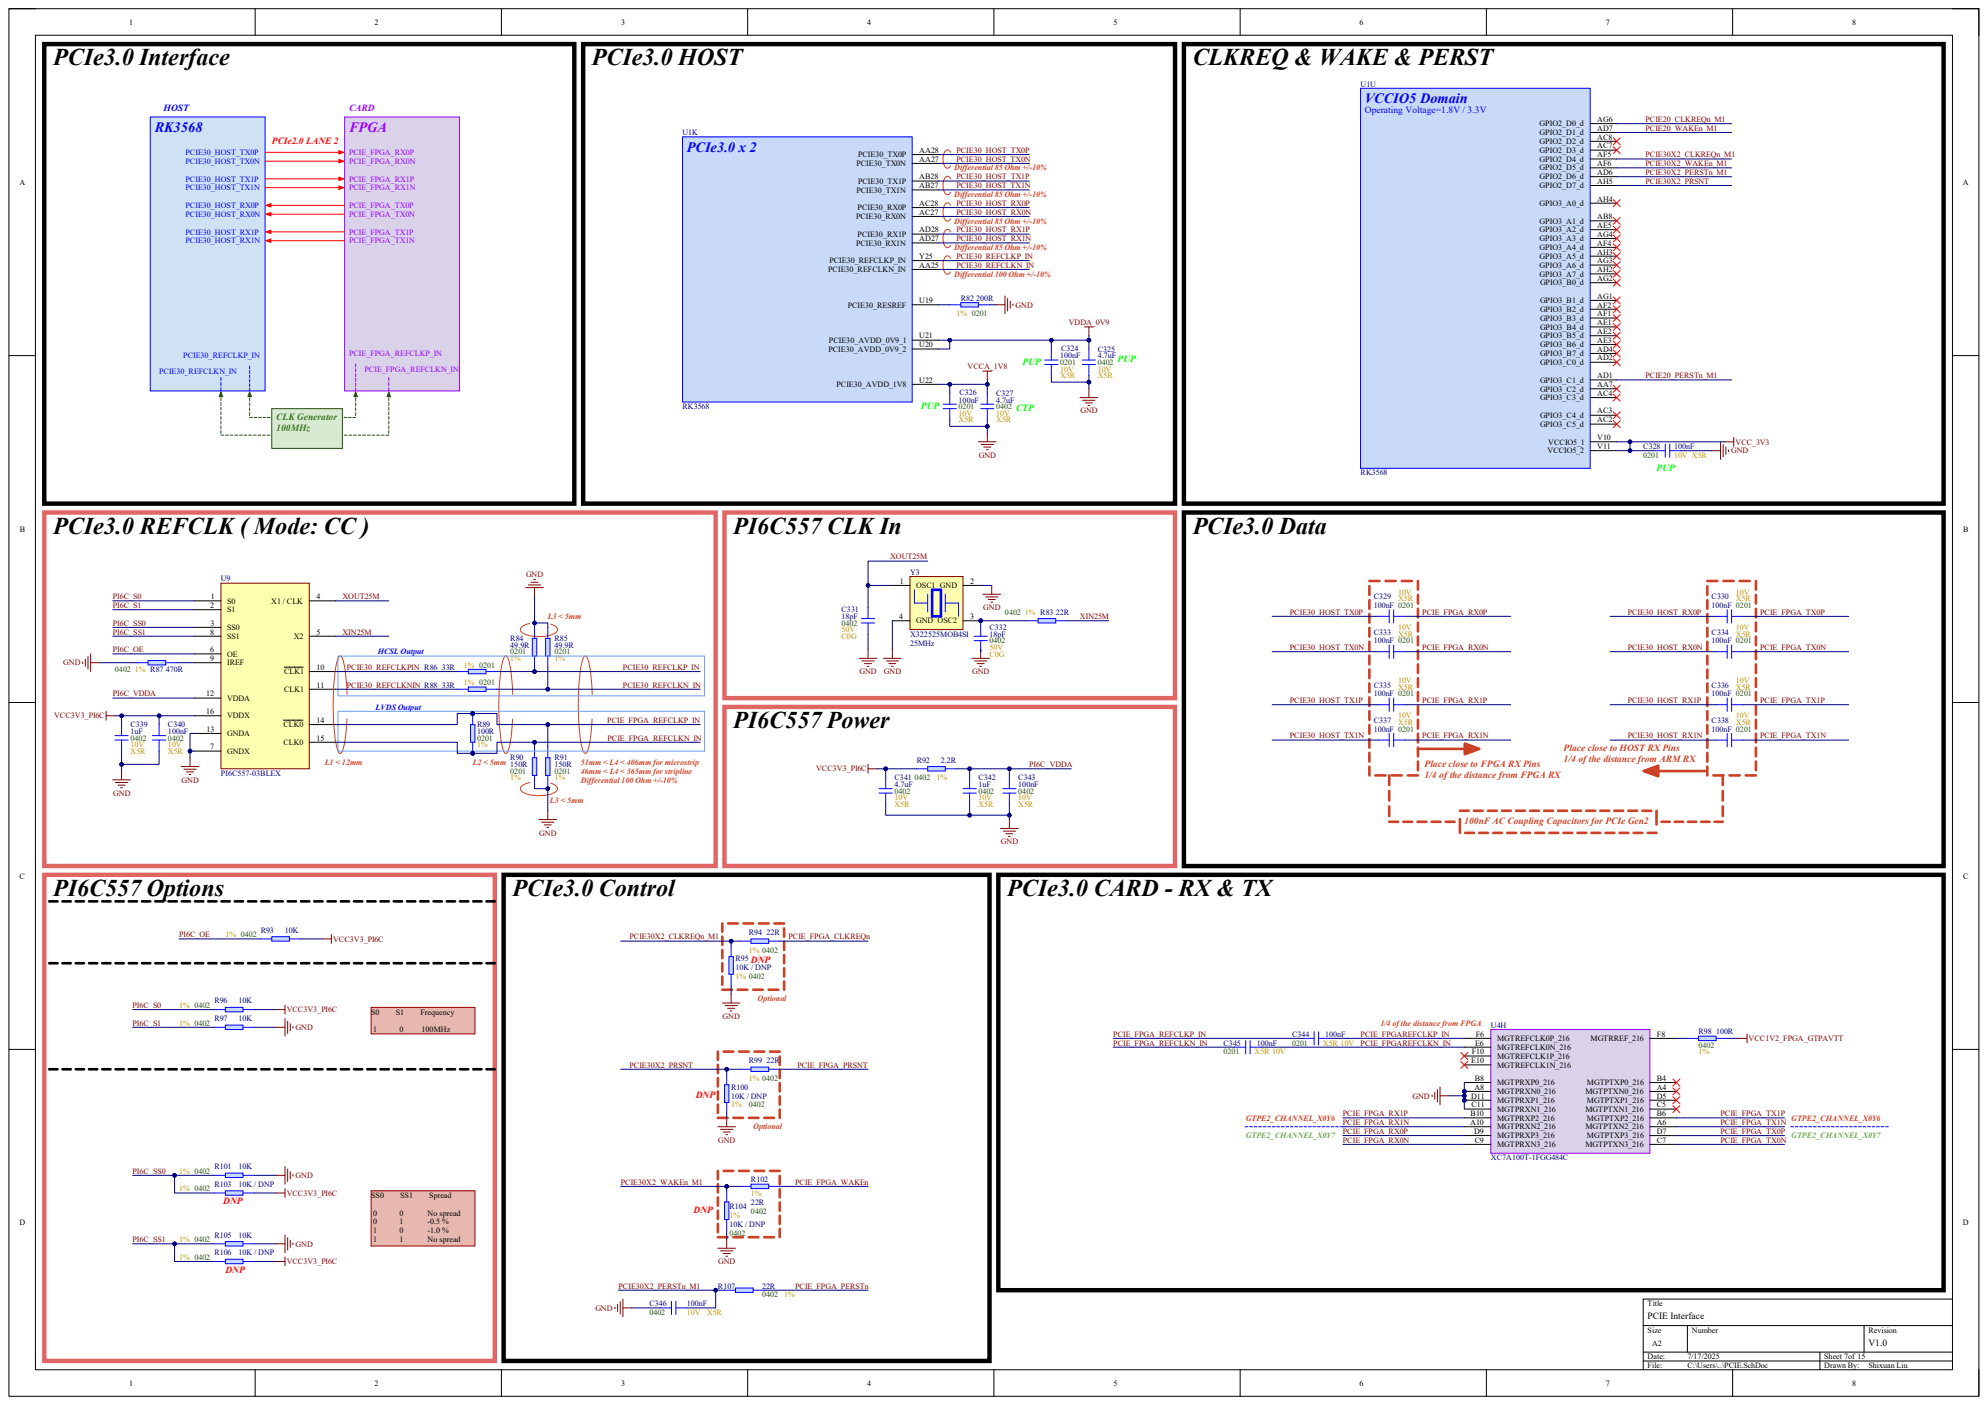
[picture p25: page 11]

Place close to HOST RX Pins
1/4 of the distance from ARM RX

Place close to FPGA RX Pins
1/4 of the distance from FPGA RX

100nF AC Coupling Capacitors for PCIe Gen2

# ADC-A

# ADC-B

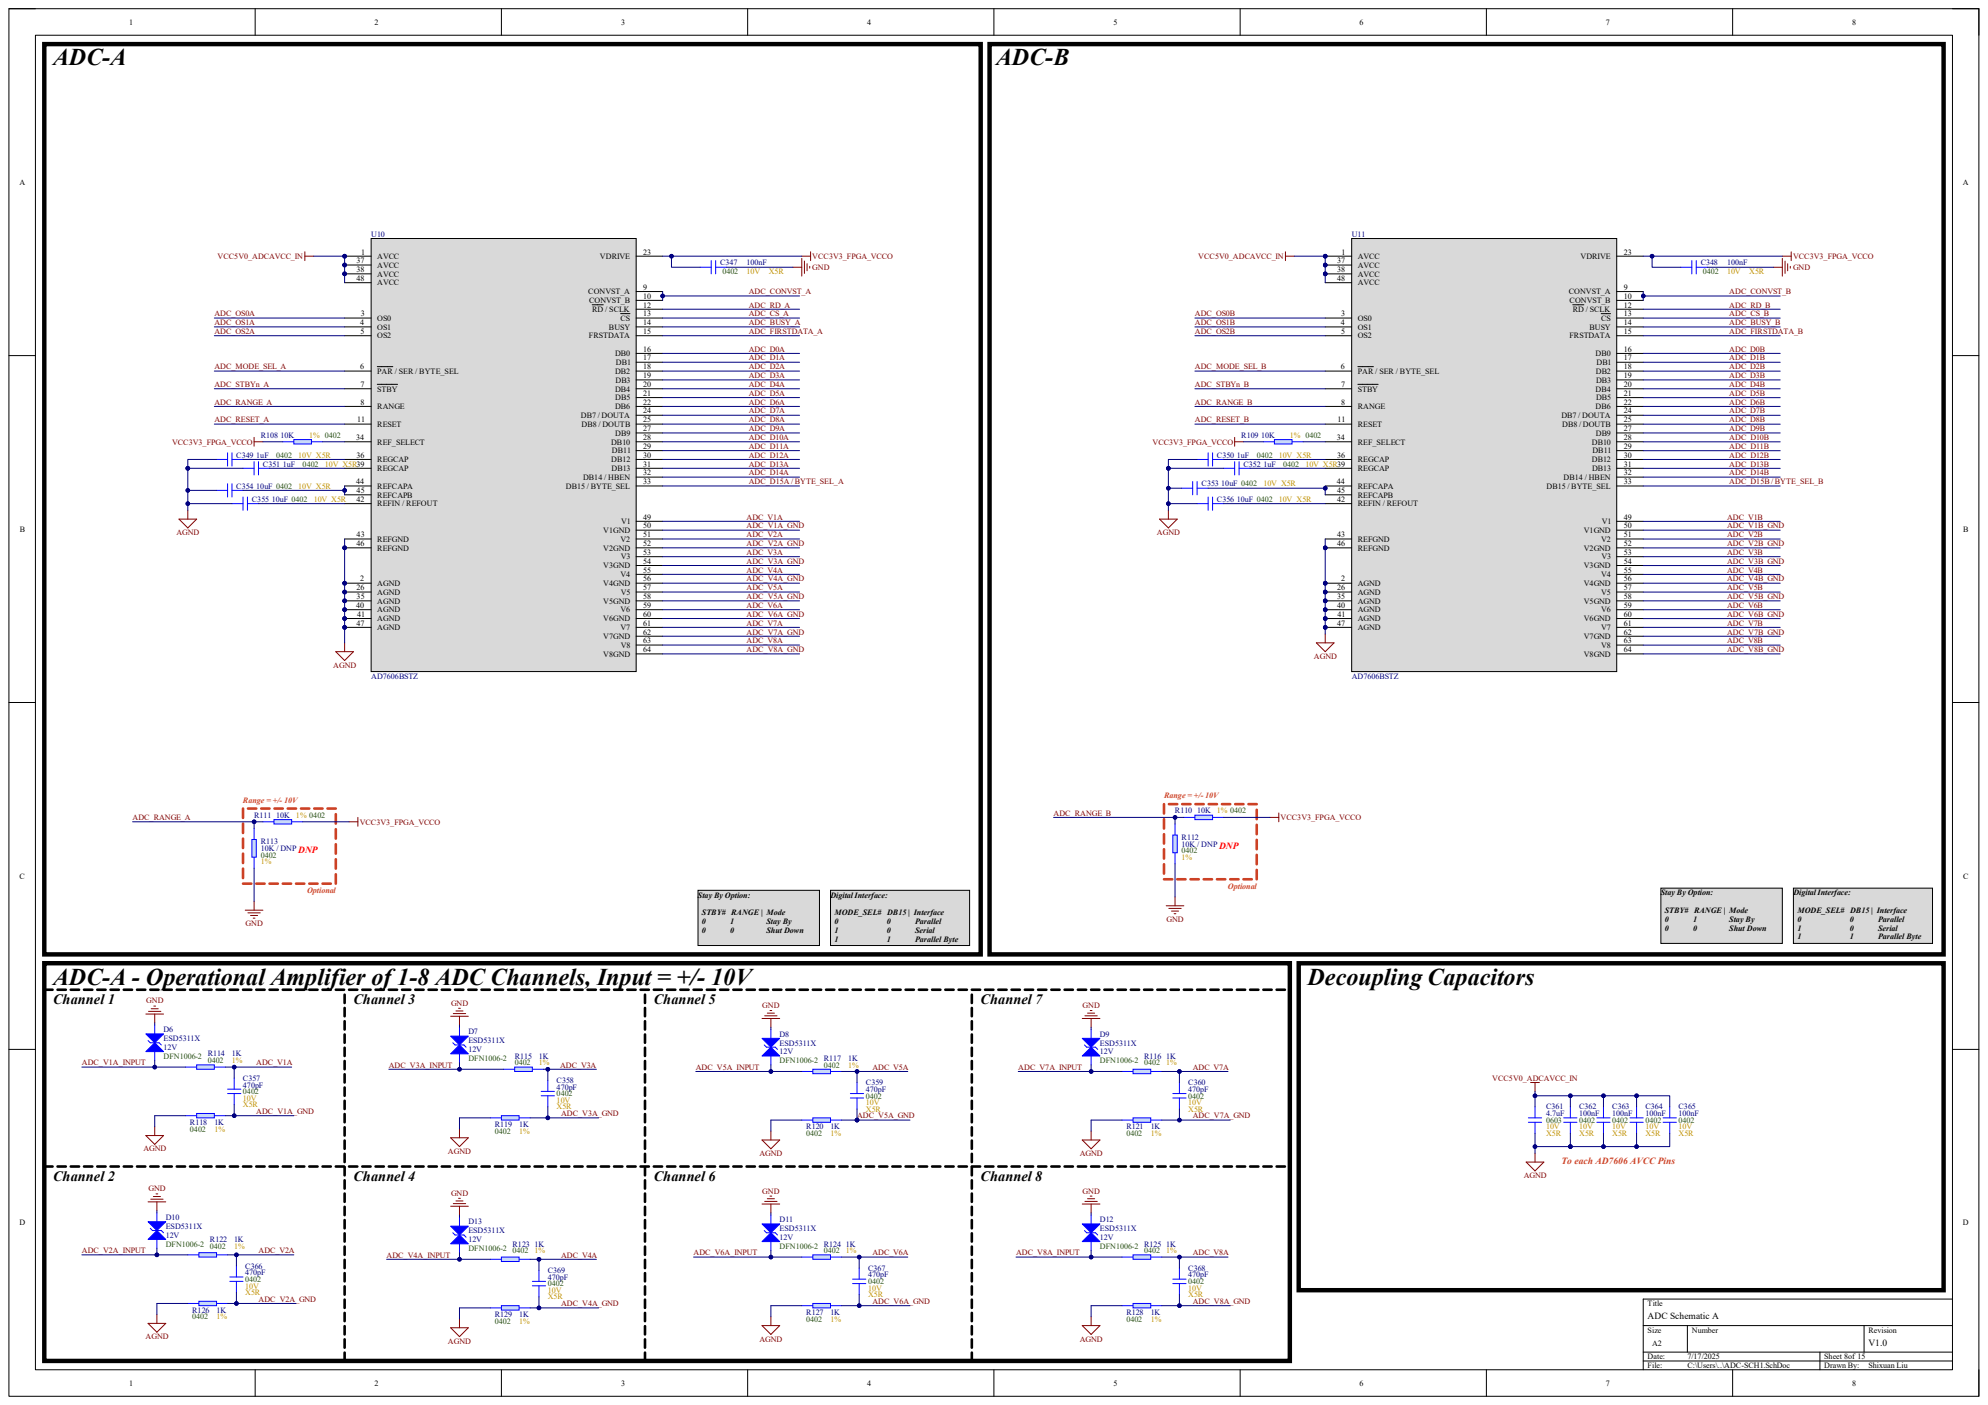
[picture p26: page 12]

ADC-A - Operational Amplifier of 1-8 ADC Channels, Input = +/- 10V

To each AD7606 AVCC Pins

IO_25_16 | F21 IO_L24N_T3_16 | G22 IO_L24P_T3_16 | G21 IO_L23N_T3_16 | D21 IO_L23P_T3_16 | E21 IO_L22N_T3_16 | D22 IO_L22P_T3_16 | E22 IO_L21N_T3_DQS_16 | A21 IO_L21P_T3_DQS_16 | B21 IO_L20N_T3_16 | B22 IO_L20P_T3_16 | C22 IO_L19N_T3_VREF_16 | C20 IO_L19P_T3_16 | D20 IO_L18N_T2_16 | F20 IO_L18P_T2_16 | F19 IO_L17N_T2_16 | A19 IO_L17P_T2_16 | A18 IO_L16N_T2_16 | A20 IO_L16P_T2_16 | B20 IO_L15N_T2_DQS_16 | E18 IO_L15P_T2_DQS_16 | F18 IO_L14N_T2_SRCC_16 | D19 IO_L14P_T2_SRCC_16 | E19 IO_L13N_T2_MRCC_16 | C19 IO_L13P_T2_MRCC_16 | C18 IO_L12N_T1_MRCC_16 | C17 IO_L12P_T1_MRCC_16 | D17 IO_L11N_T1_SRCC_16 | B18 IO_L11P_T1_SRCC_16 | B17 IO_L10N_T1_16 | A14 IO_L10P_T1_16 | A13 IO_L9N_T1_DQS_16 | A16 IO_L9P_T1_DQS_16 | A15 IO_L8N_T1_16 | B13 IO_L8P_T1_16 | C13 IO_L7N_T1_16 | B16 IO_L7P_T1_16 | B15 IO_L6N_T0_VREF_16 | D15 IO_L6P_T0_16 | D14 IO_L5N_T0_16 | D16 IO_L5P_T0_16 | E16 IO_L4N_T0_16 | E14 IO_L4P_T0_16 | E13 IO_L3N_T0_DQS_16 | C15 IO_L3P_T0_DQS_16 | C14 IO_L2N_T0_16 | E17 IO_L2P_T0_16 | F16 IO_L1N_T0_16 | F14 IO_L1P_T0_16 | F13 IO_0_16 | F15 BANK 16

# FPAG ADC-A Controller

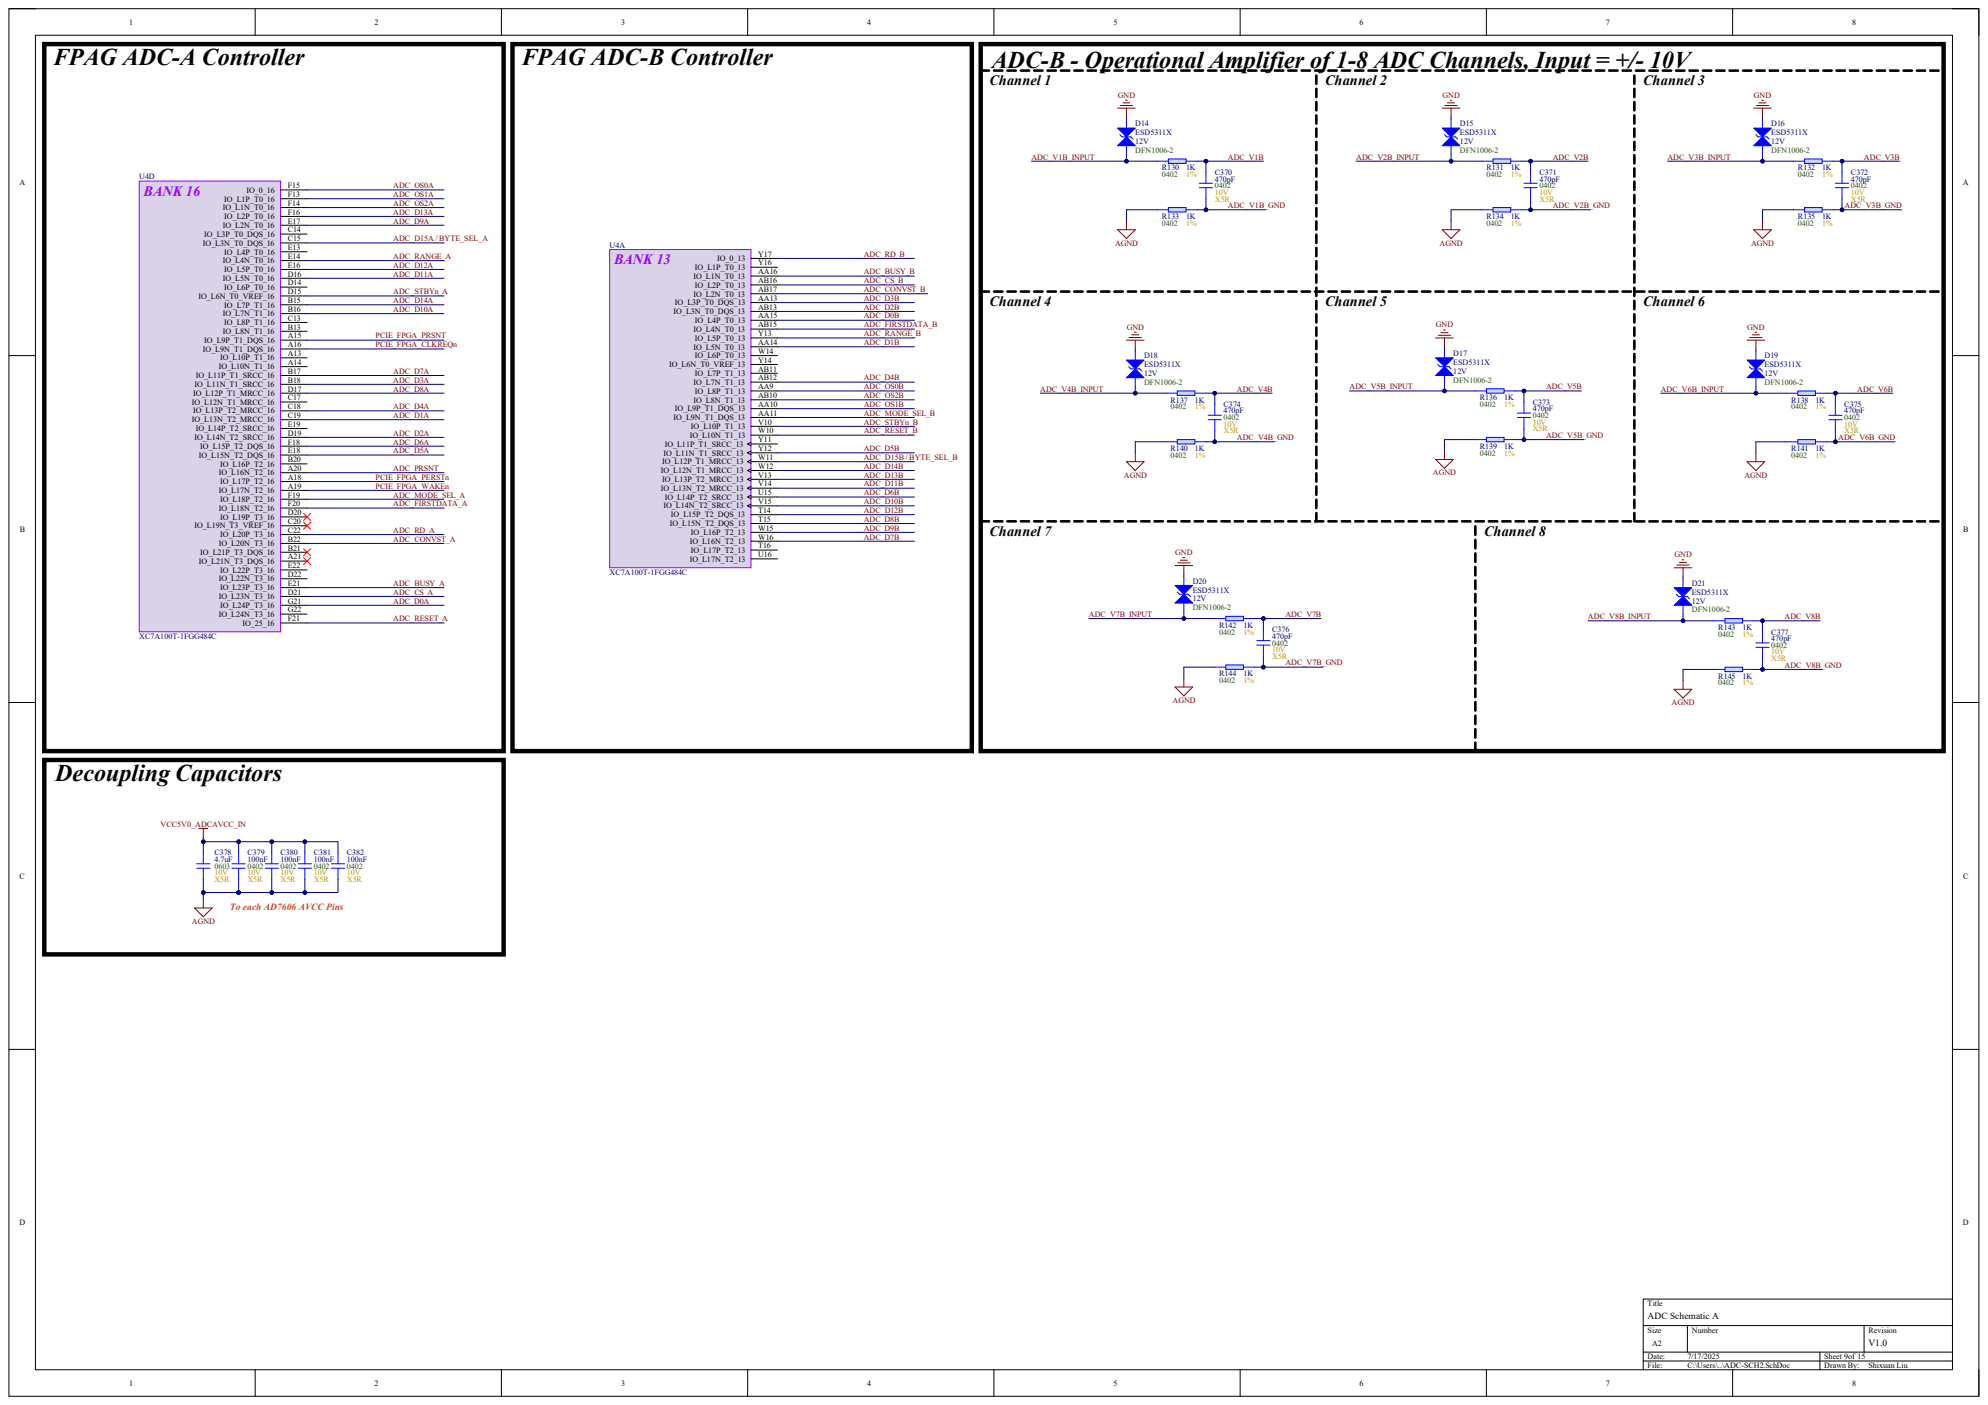
[picture p27: page 13]

ADC-B - Operational Amplifier of 1-8 ADC Channels, Input = +/- 10V

To each AD7606 AVCC Pins

# USB3.0 OTG0 ( Linux Download - Special Interface )

# WIFI Module

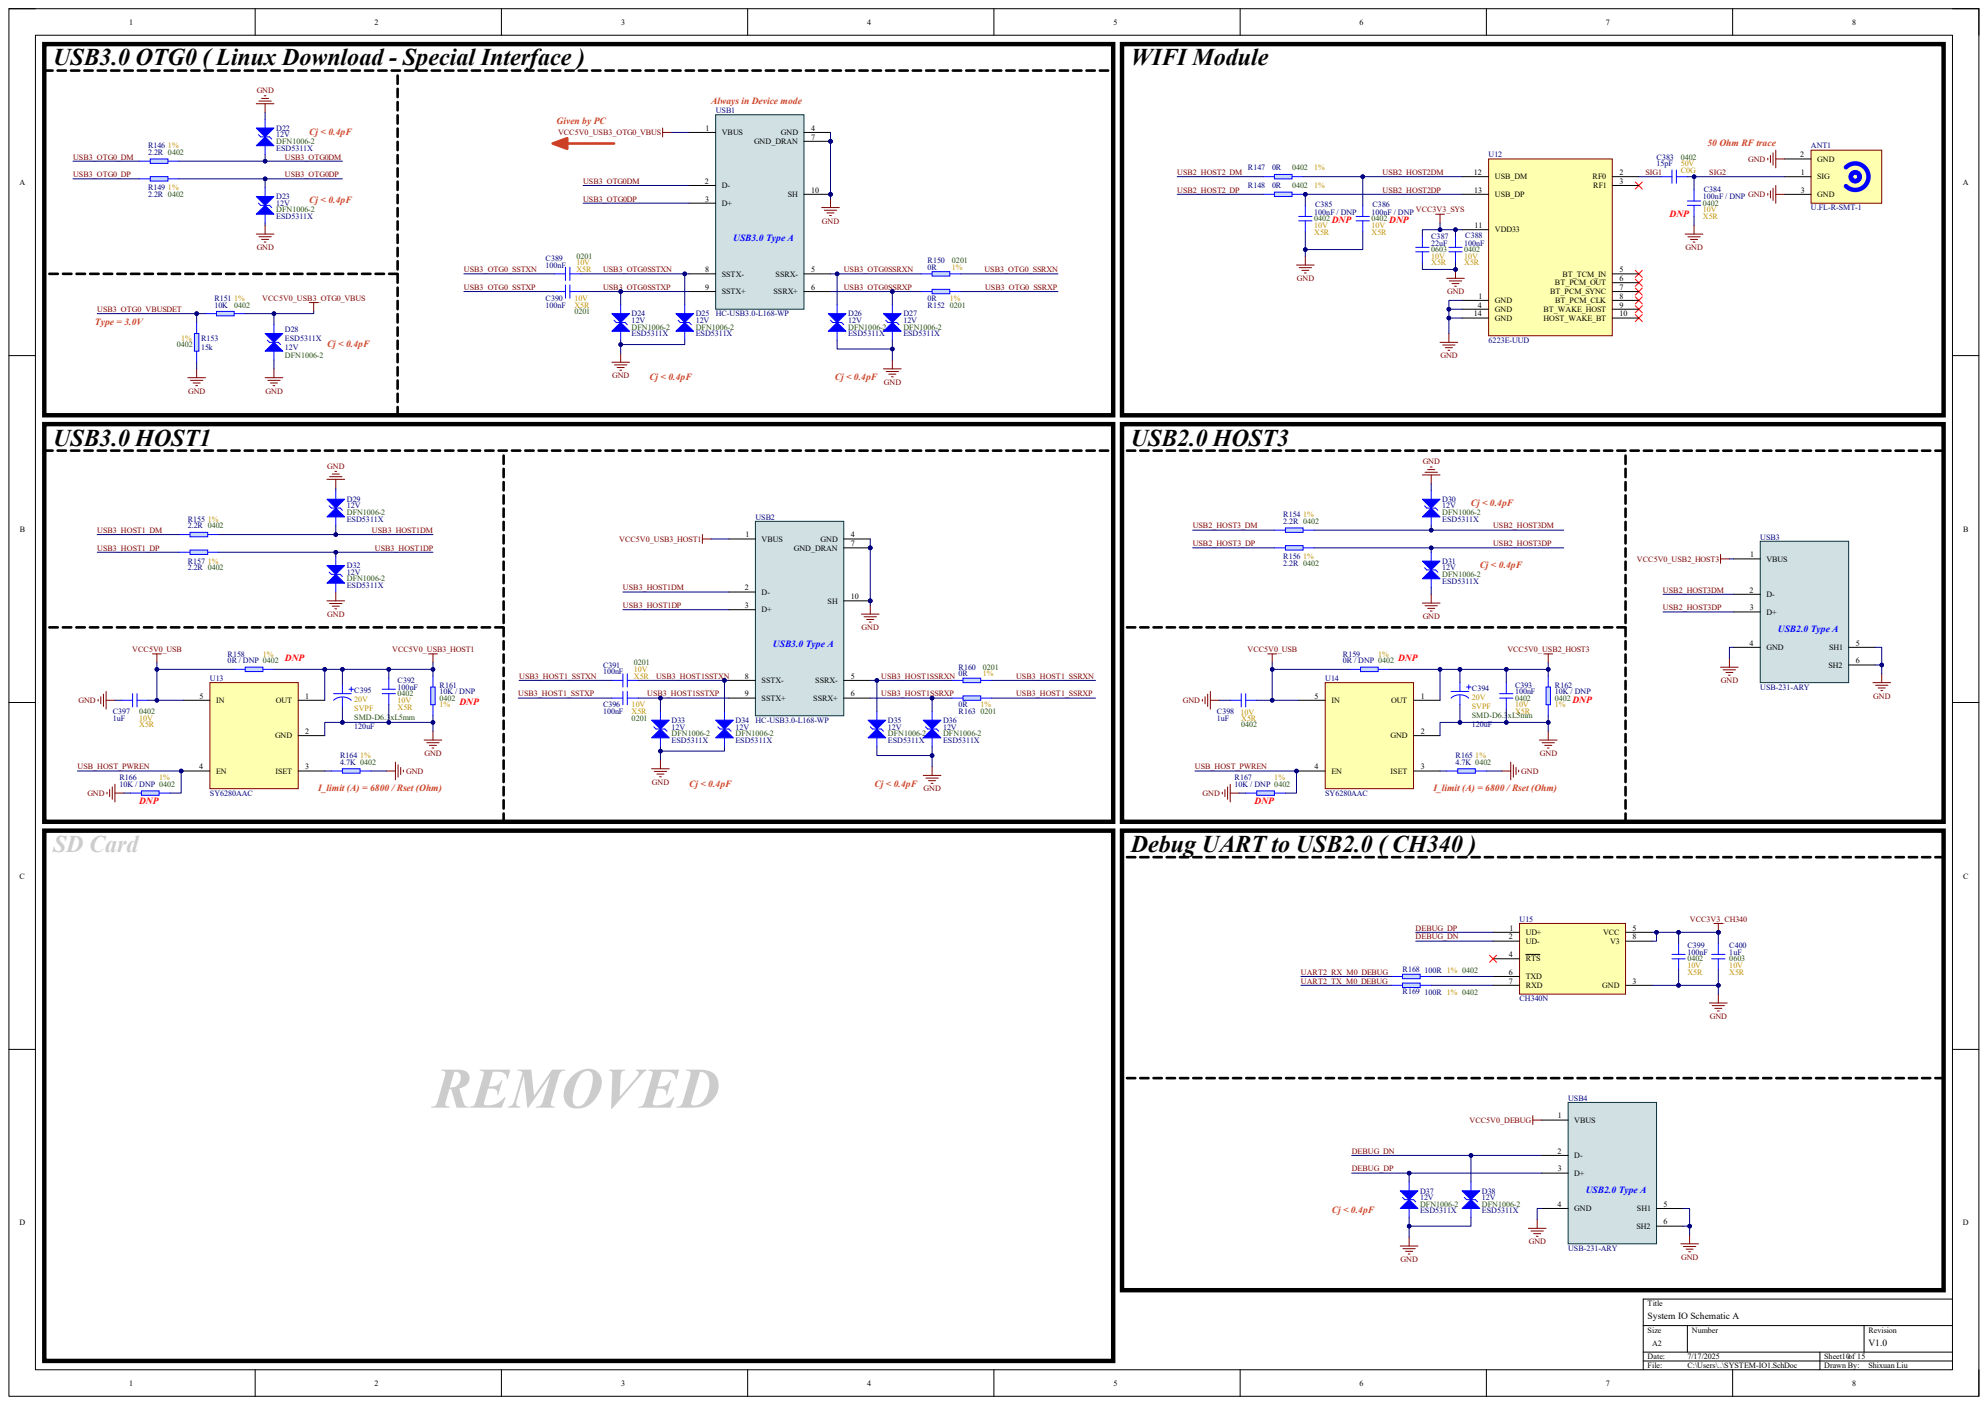
[picture p28: page 14]

# FPGA JTAG to USB2.0

# FT2232 Reset

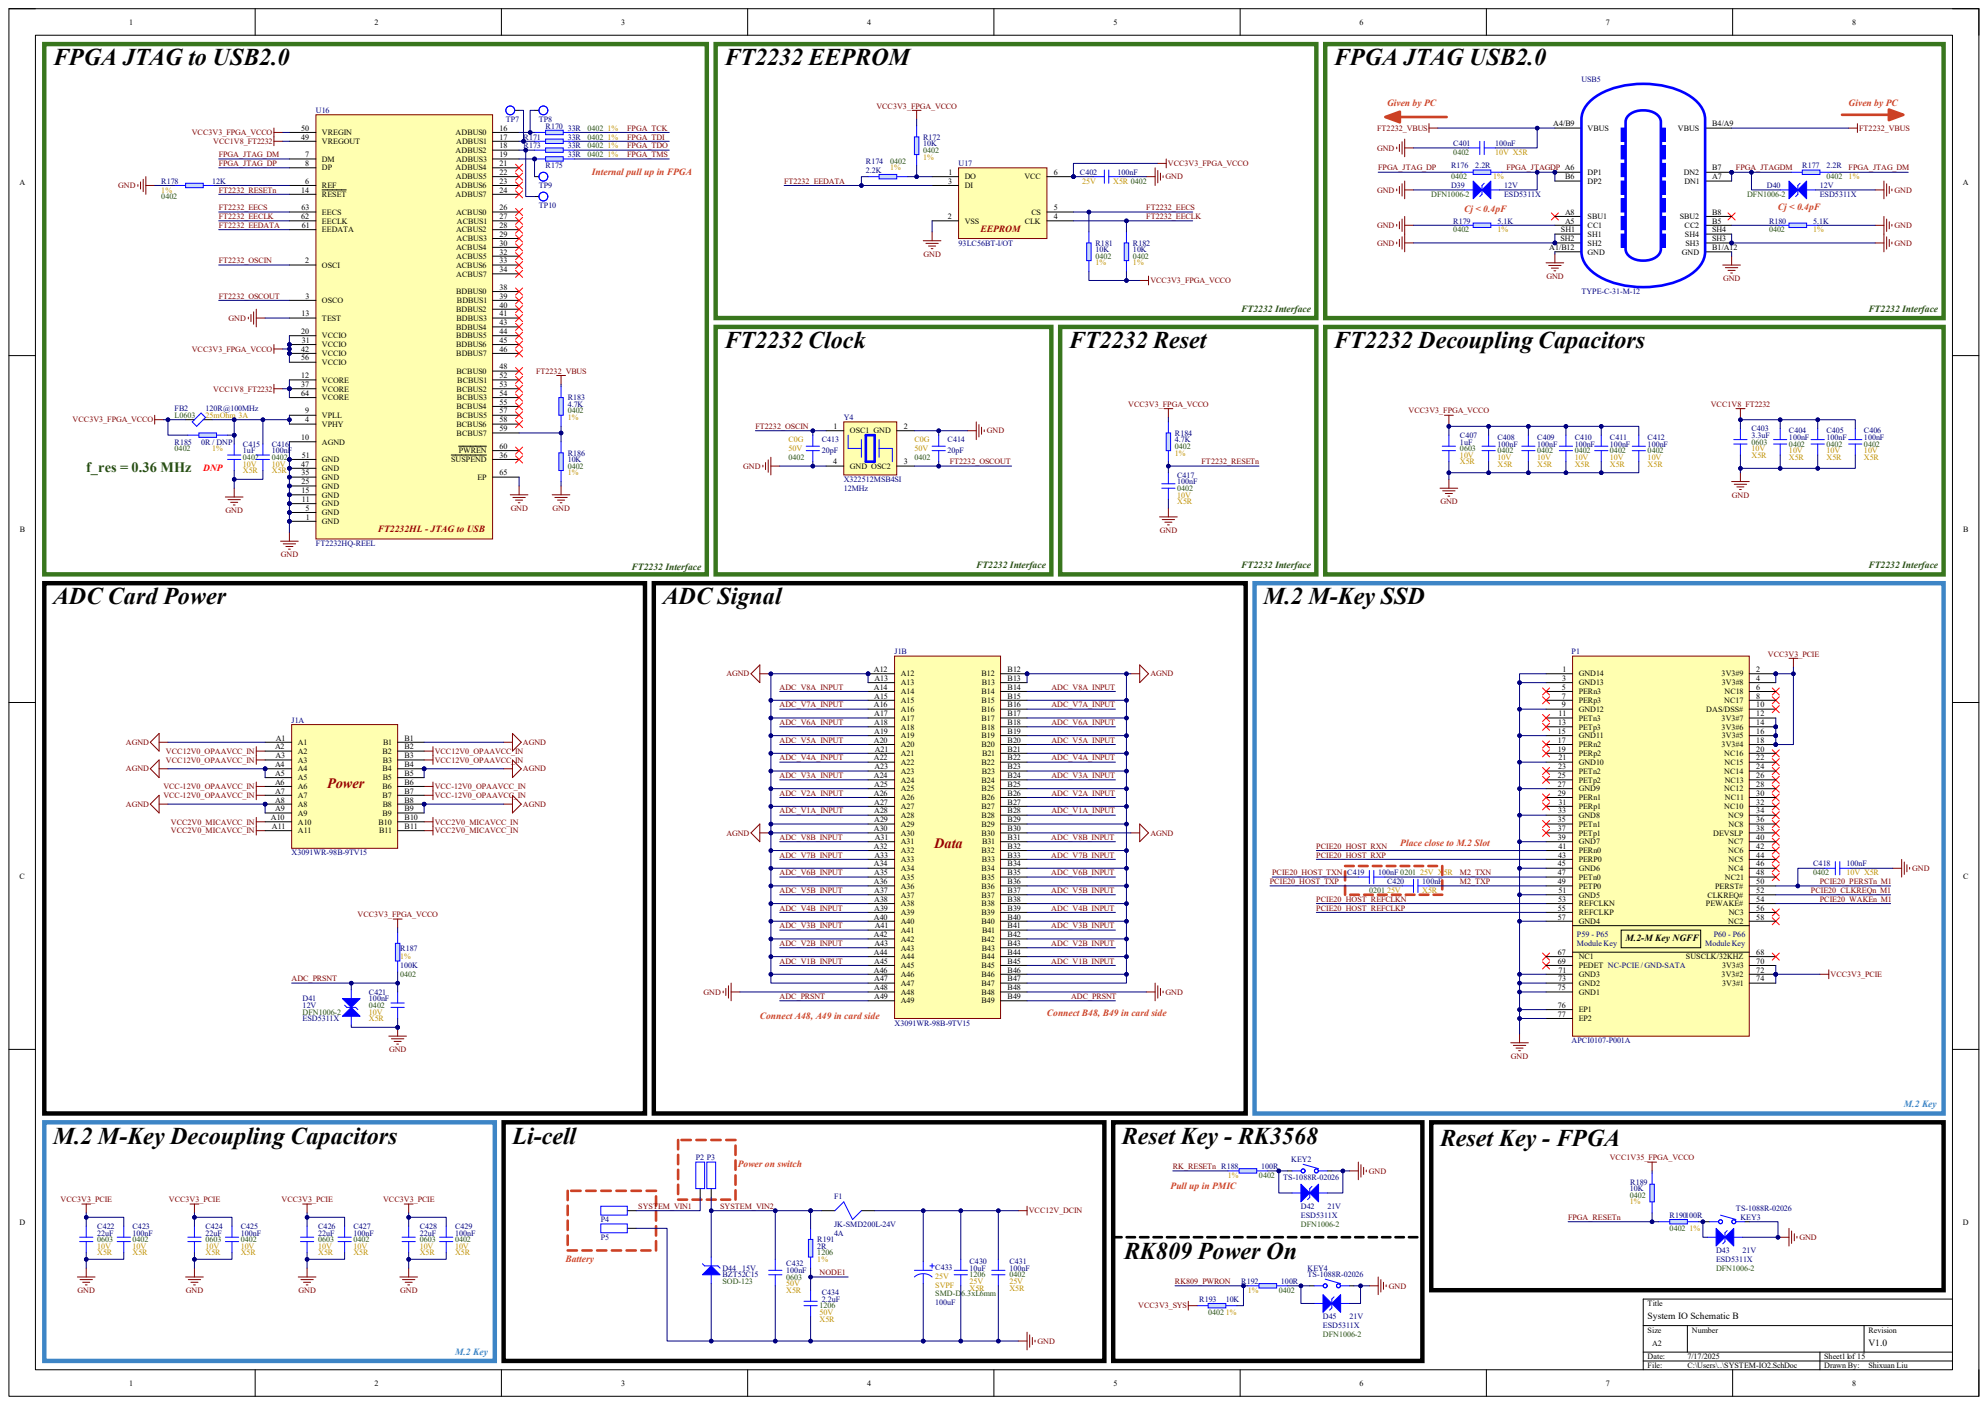
[picture p29: page 15]

Internal pull up in FPGA

Place close to M.2 Slot

NC-PCIE / GND-SATA

Pull up in PMIC

LED - ARM Ready | LED - FPGA Ready | LED - ADC-A Card Present LED - Sampling

# GMAC PHY

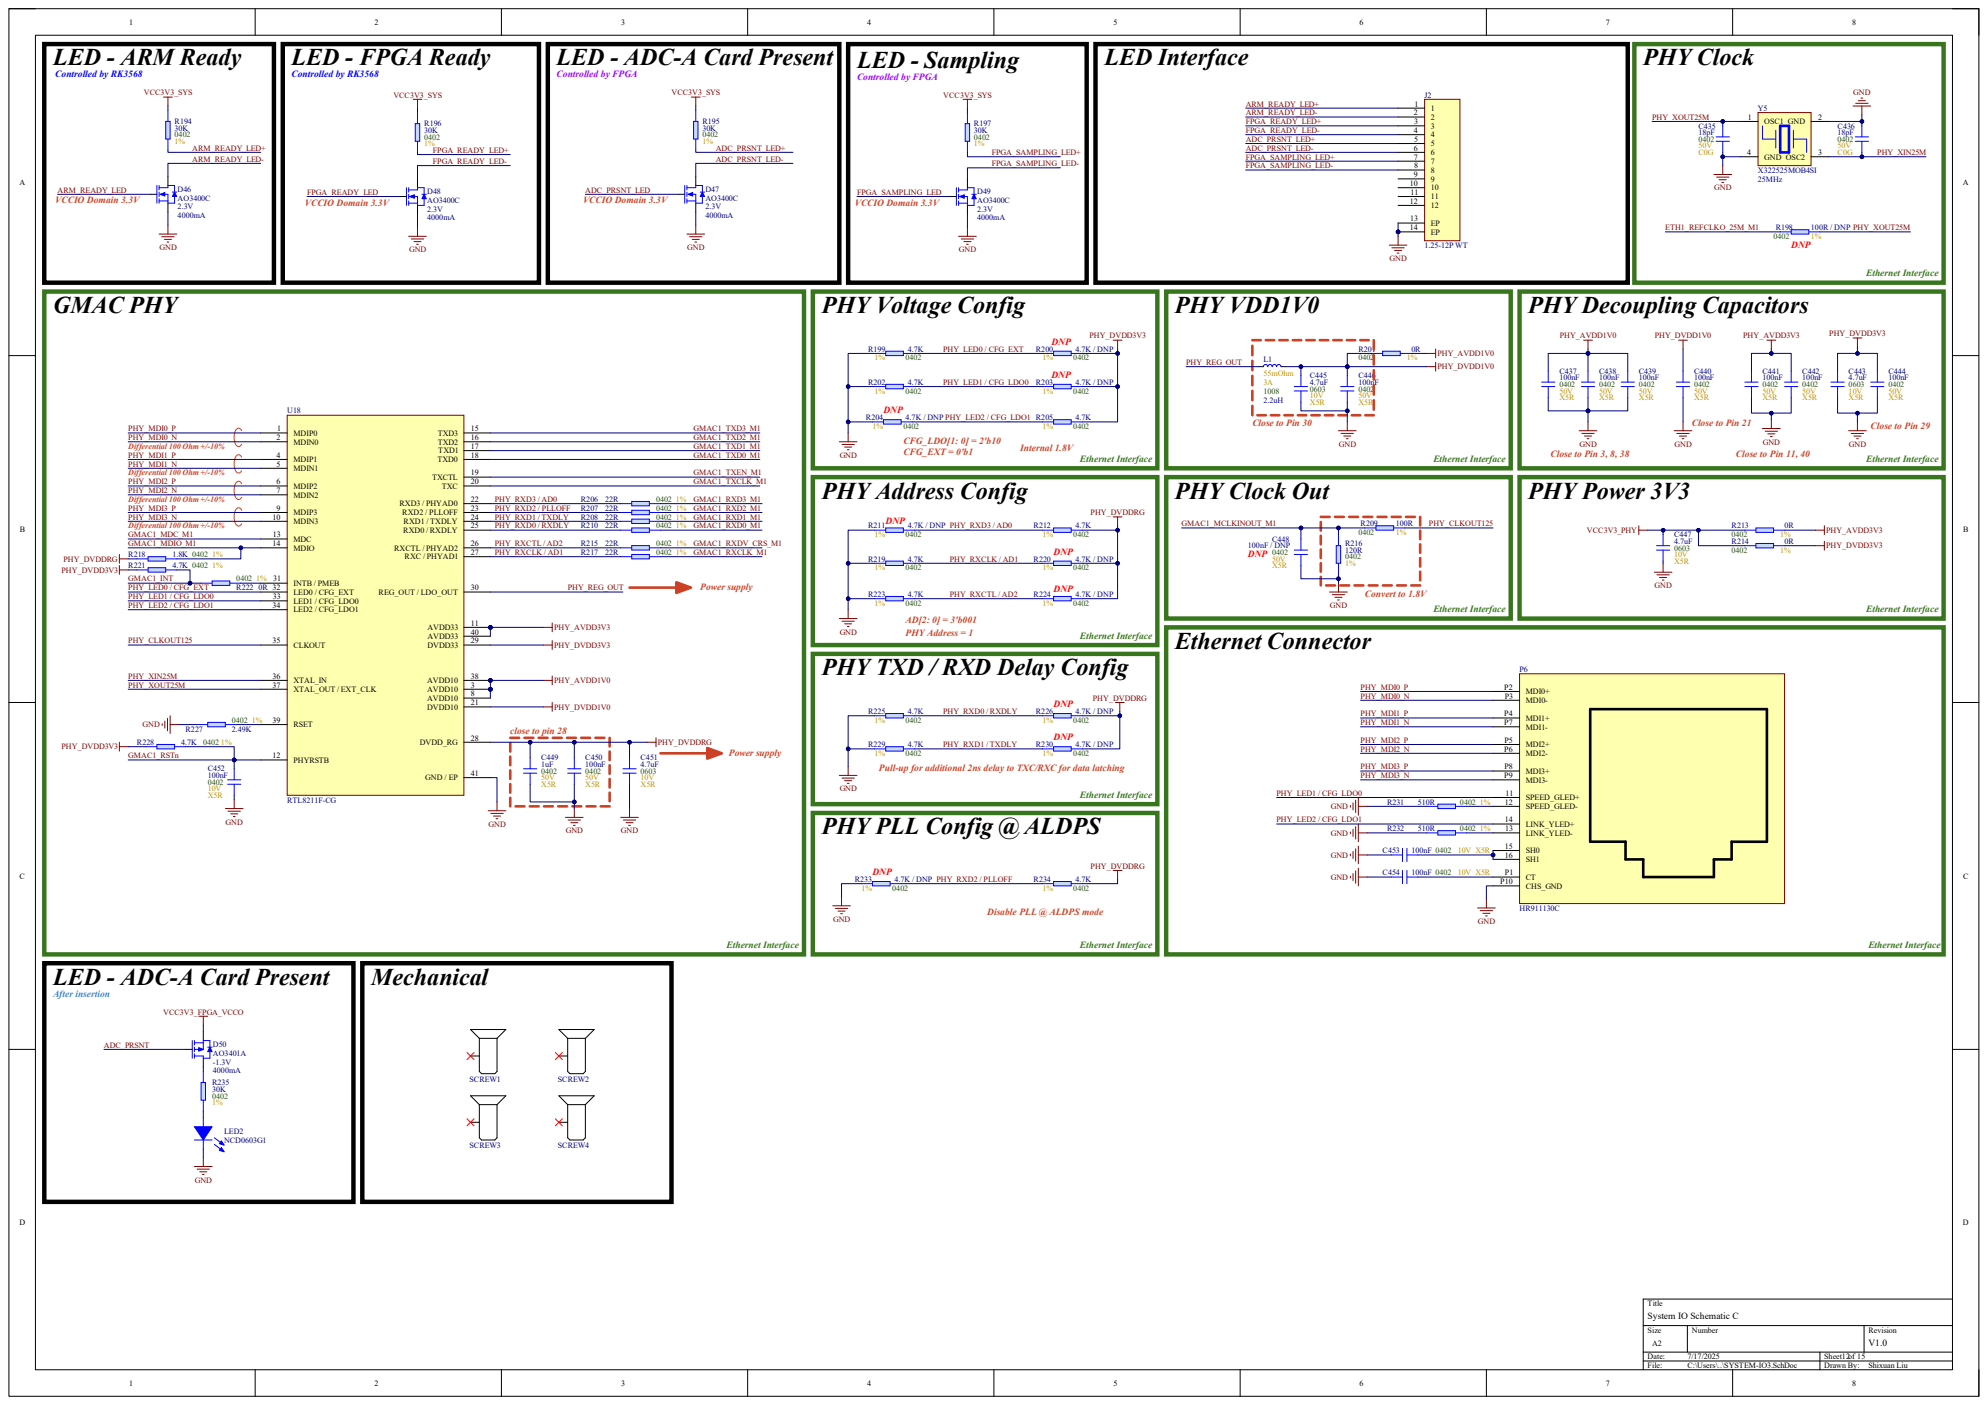
[picture p30: page 16]

GND
PHY TXD / RXD Delay Config

Pull-up for additional 2ns delay to TXC/RXC for data latching
PHY PLL Config @ ALDPS

Disable PLL @ ALDPS mode

LED - ADC-A Card Present

# 12V_DCIN to VCC3V3_SYS

# 12V_DCIN to VCC5V0_SYS

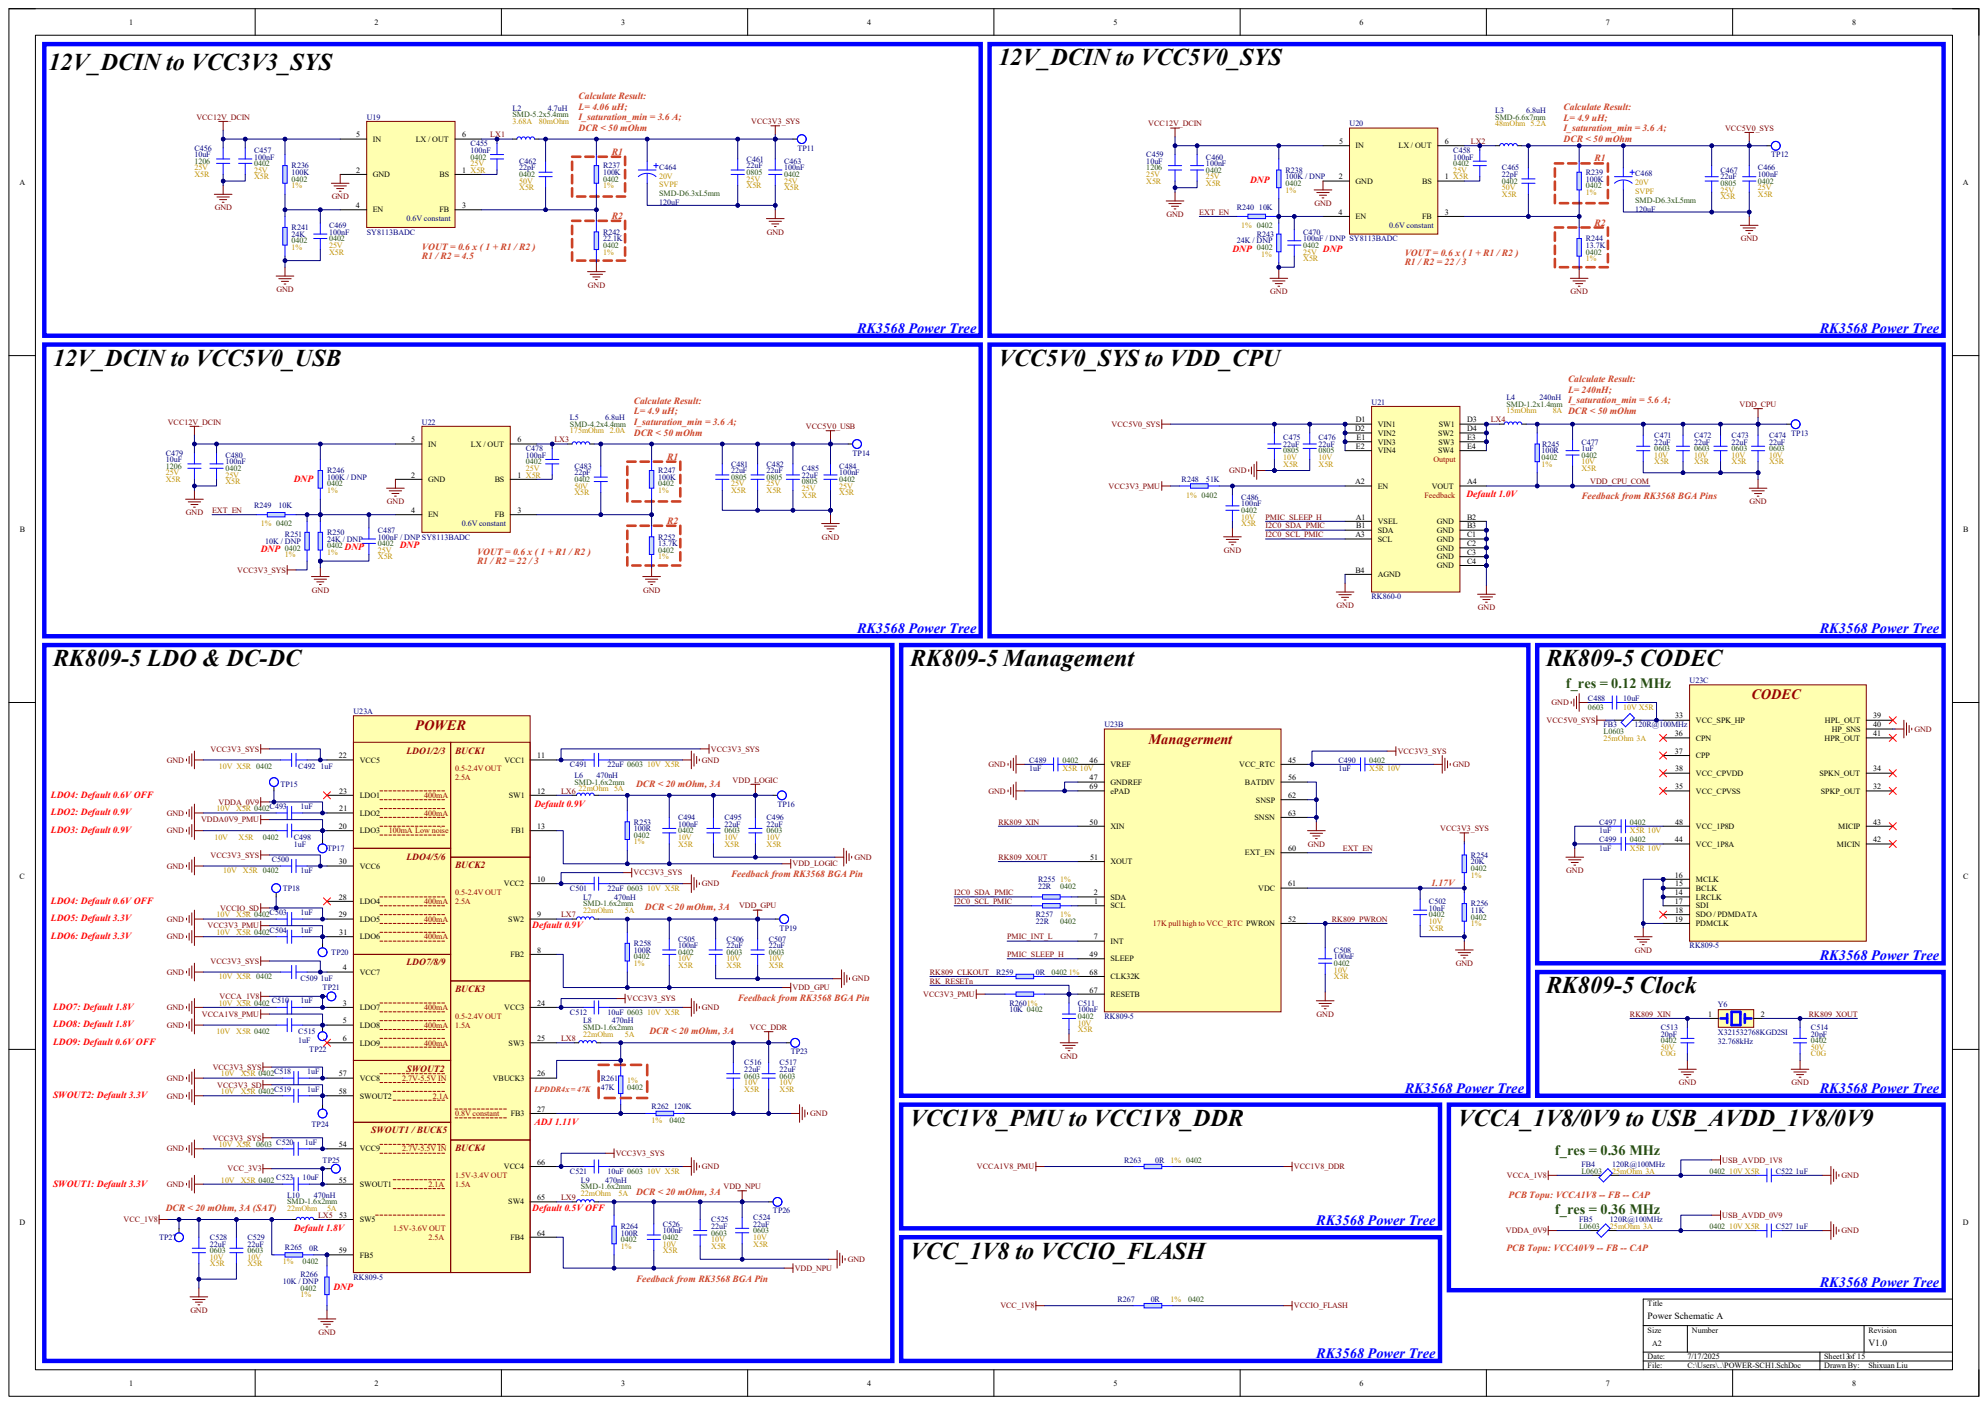
[picture p31: page 17]

Feedback from RK3568 BGA Pin

VDDA_0V9
PCB Topu: VCCA0V9 -- FB -- CAP

# 12V_DCIN to VCC3V3_PCIE

# VCC3V3_SYS to VCC0V6_DDR

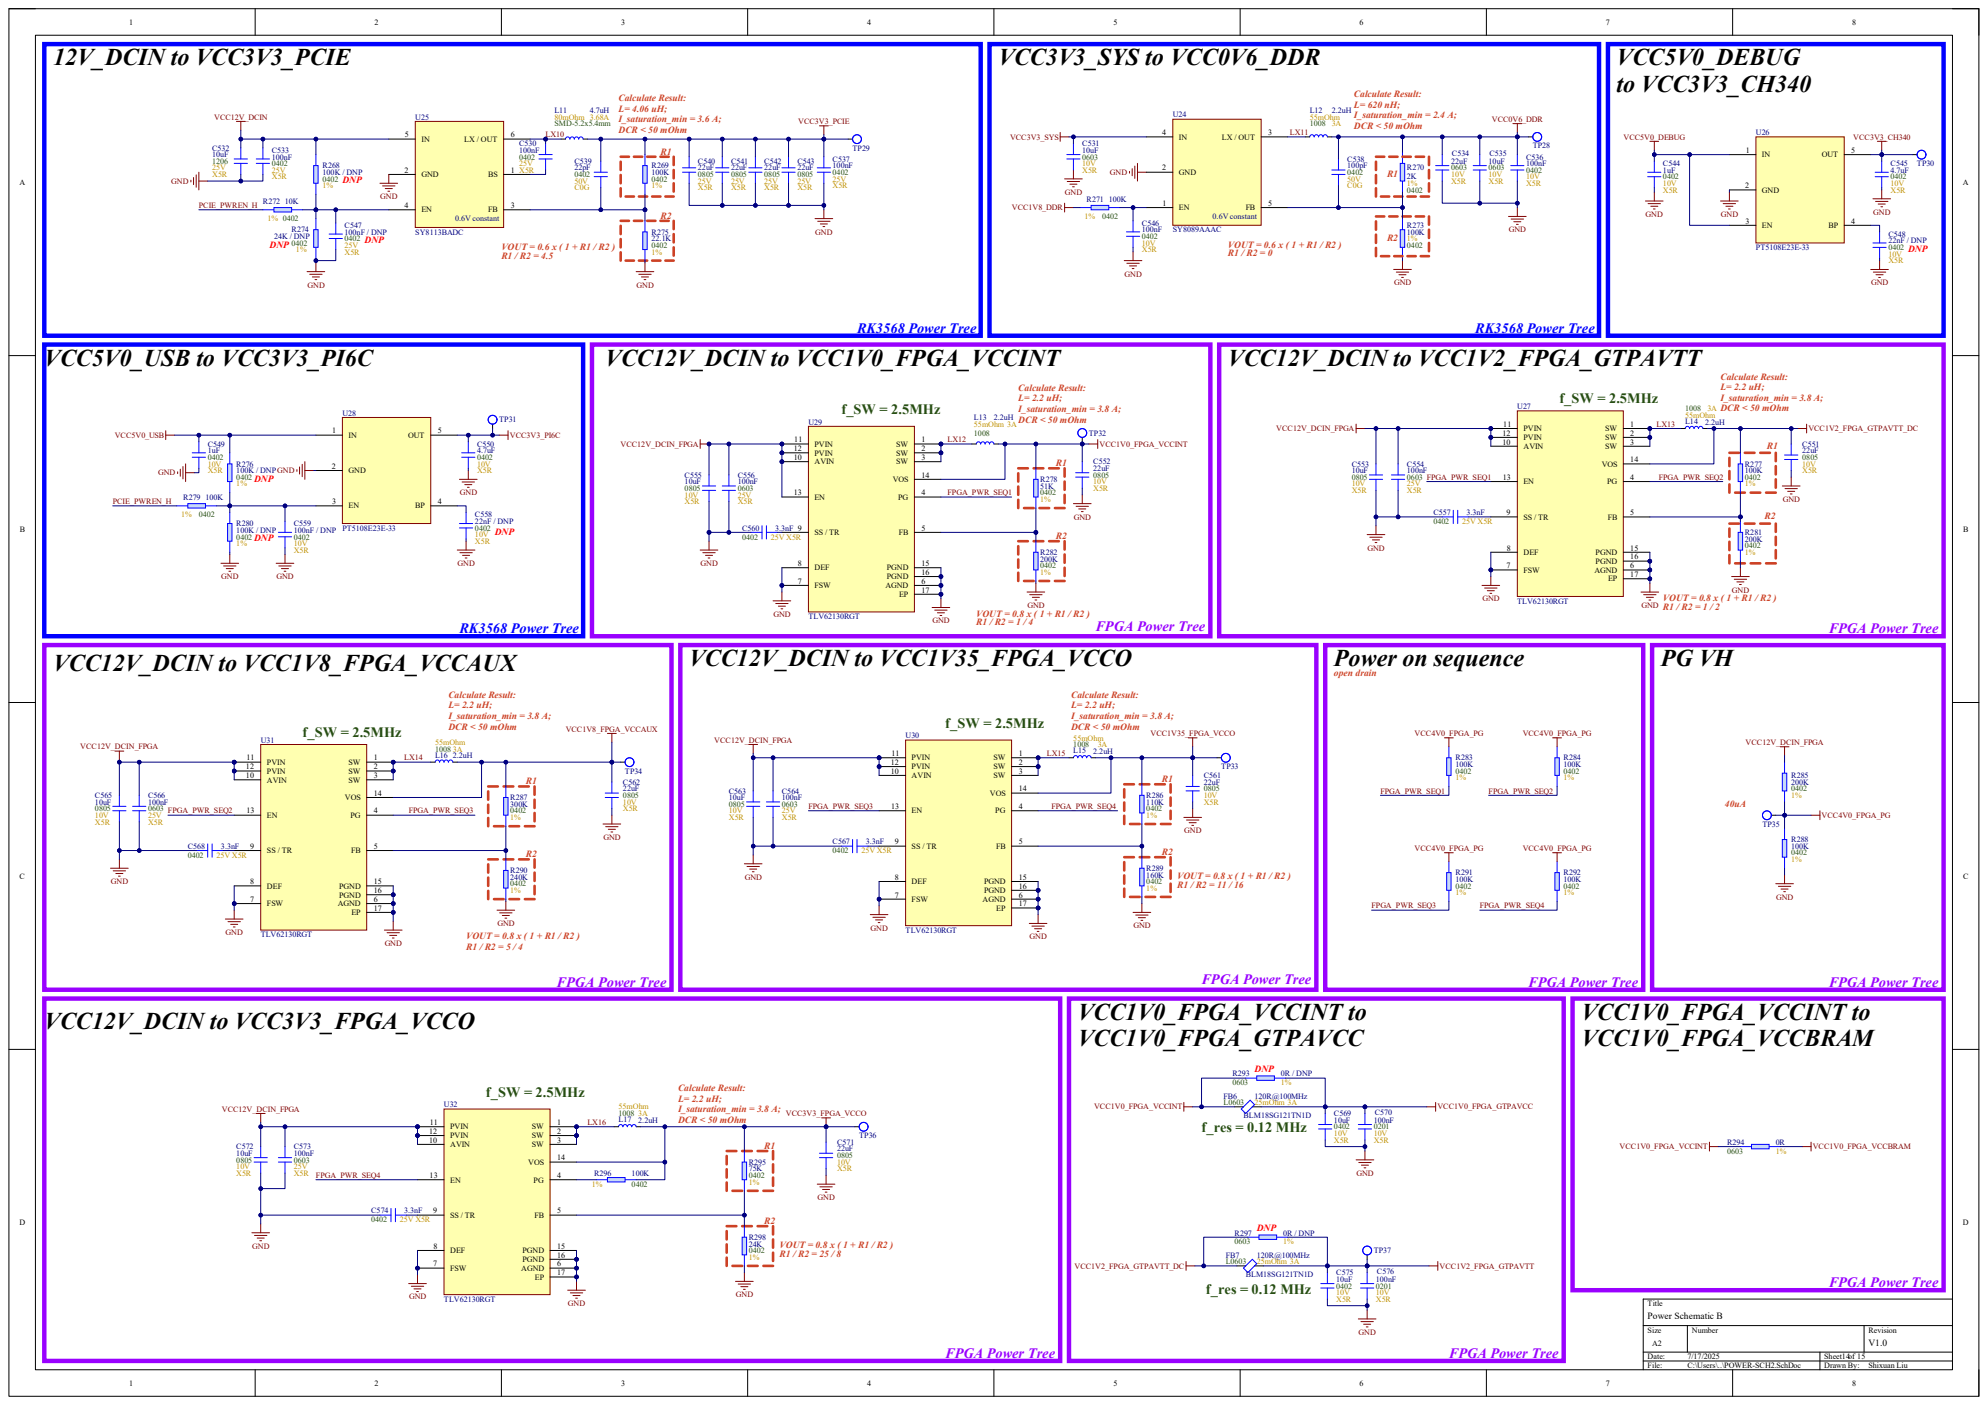
[picture p32: page 18]

VCC12V_DCIN to VCC5V0_ADCAVCC | VCC5V0_ADCAVCC to VCC-12V0_OPAAVCC

# VCC12V0_OPAAVCC to

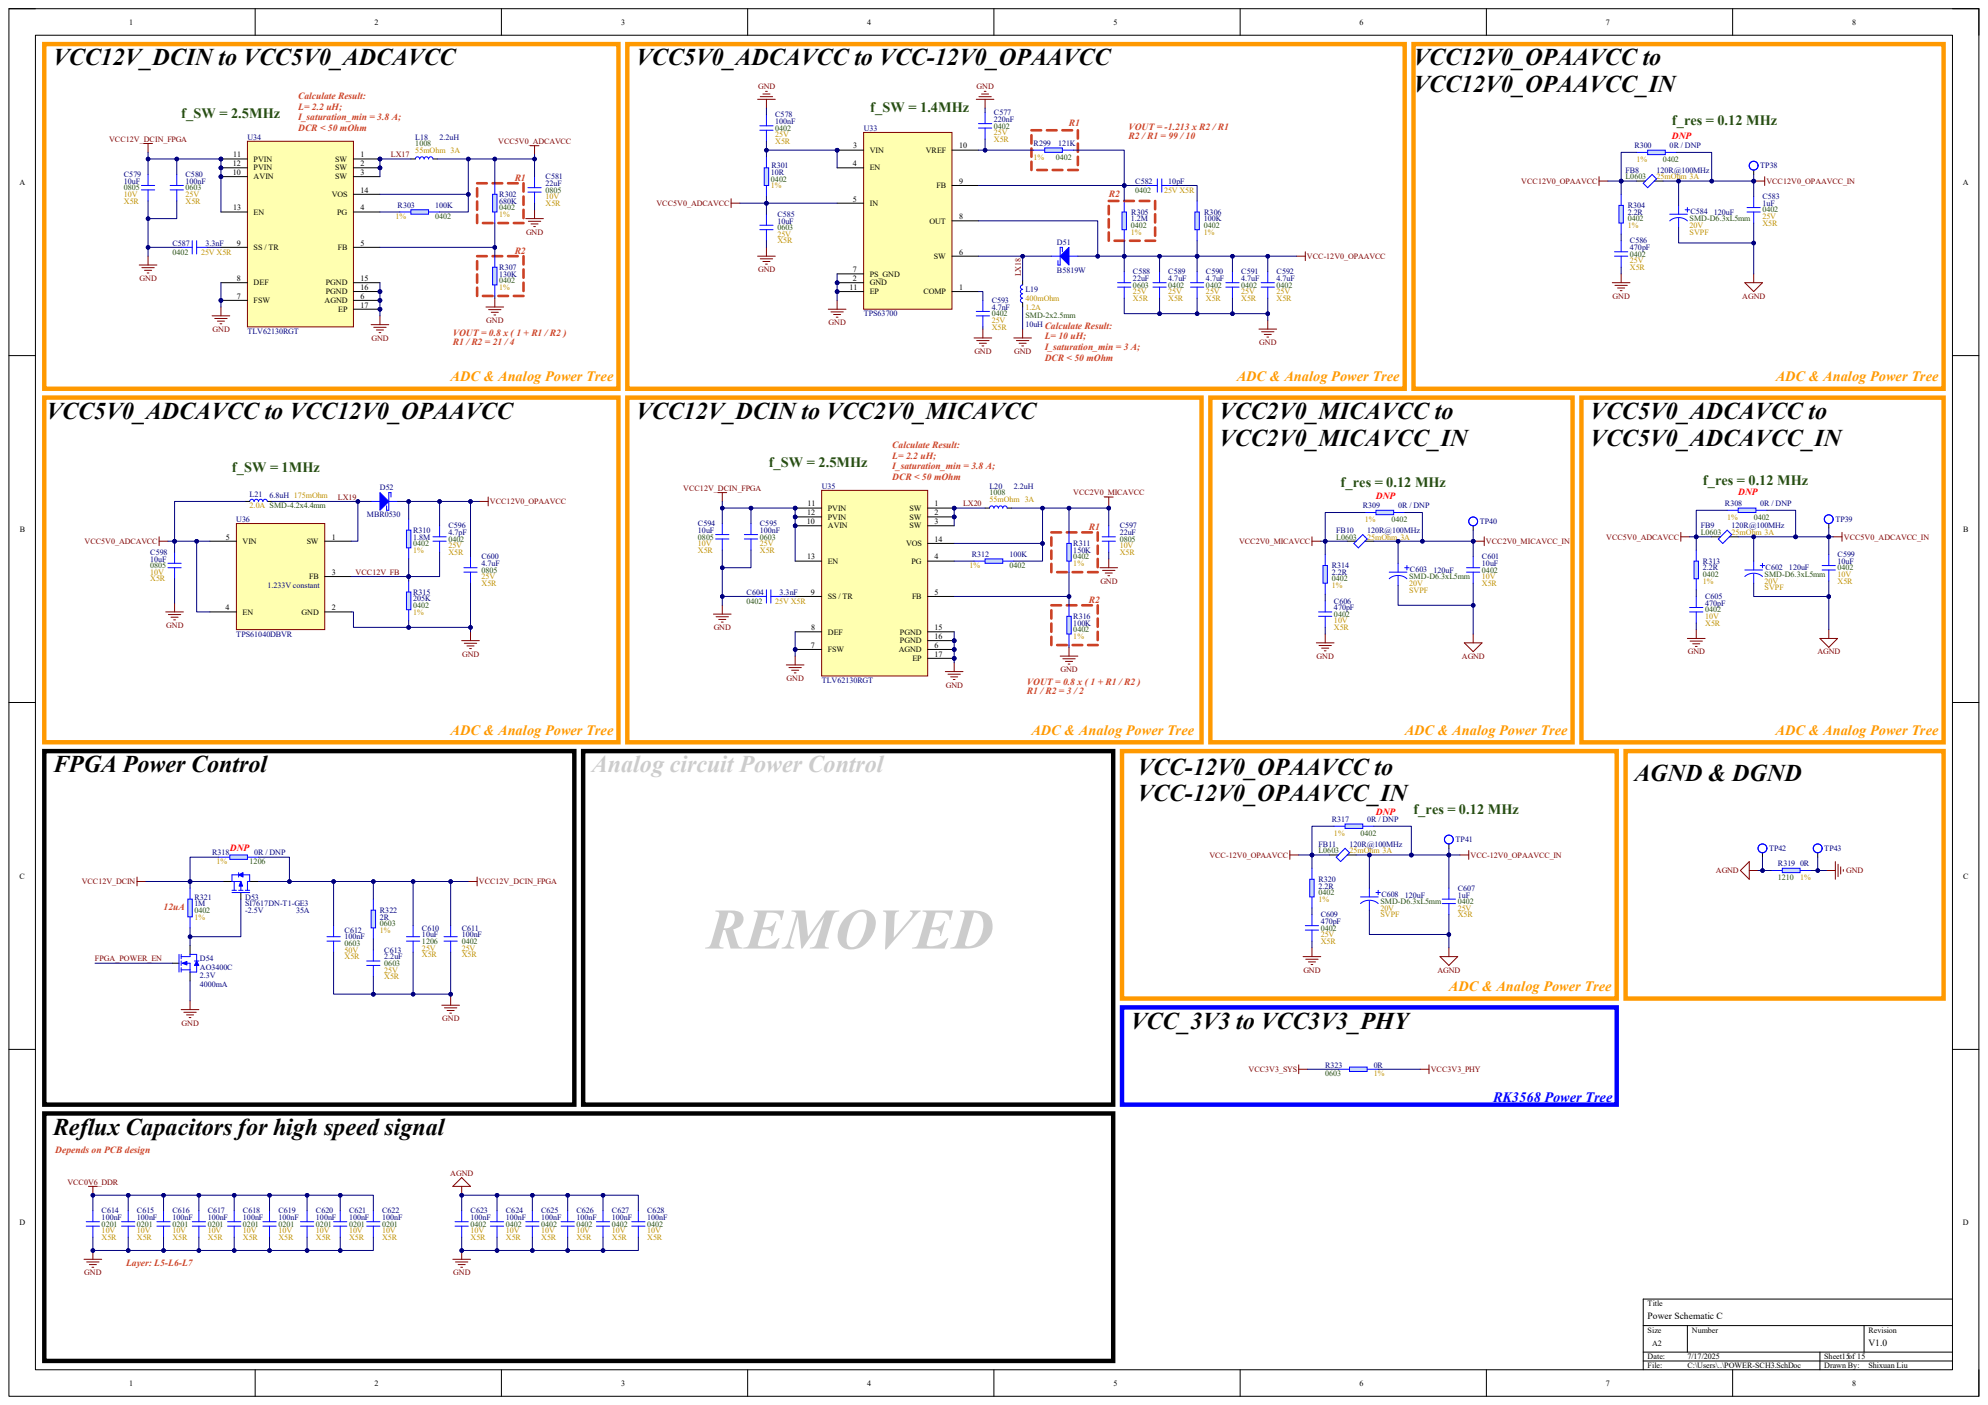
[picture p33: page 19]

ADC & Analog Power Tree

AGND

Reflux Capacitors for high speed signal

Depends on PCB design
