ShixuanLiu9527/VUPRS-Support/doc/VUPRS-Mic-Array.pdf

B49 B49 B48 B48 B47 B47 B46 B46 B45 B45 B44 B44 B43 B43 B42 B42 B41 B41 B40 B40 B39 B39 B38 B38 B37 B37 B36 B36 B35 B35 B34 B34 B33 B33 B32 B32 B31 B31 B30 B30 B29 B29 B28 B28 B27 B27 B26 B26 B25 B25 B24 B24 B23 B23 B22 B22 B21 B21 B20 B20 B19 B19 B18 B18 B17 B17 B16 B16 B15 B15 B14 B14 B13 B13 B12 B12 B11 B11 B10 B10 B9 B9 B8 B8 B7 B7 B6 B6 B5 B5 B4 B4 B3 B3 B2 B2 B1 B1

A49 A49 A48 A48 A47 A47 A46 A46 A45 A45 A44 A44 A43 A43 A42 A42 A41 A41 A40 A40 A39 A39 A38 A38 A37 A37 A36 A36 A35 A35 A34 A34 A33 A33 A32 A32 A31 A31 A30 A30 A29 A29 A28 A28 A27 A27 A26 A26 A25 A25 A24 A24 A23 A23 A22 A22 A21 A21 A20 A20 A19 A19 A18 A18 A17 A17 A16 A16 A15 A15 A14 A14 A13 A13 A12 A12 A11 A11 A10 A10 A9 A9 A8 A8 A7 A7 A6 A6 A5 A5 A4 A4 A3 A3 A2 A2 A1 A1

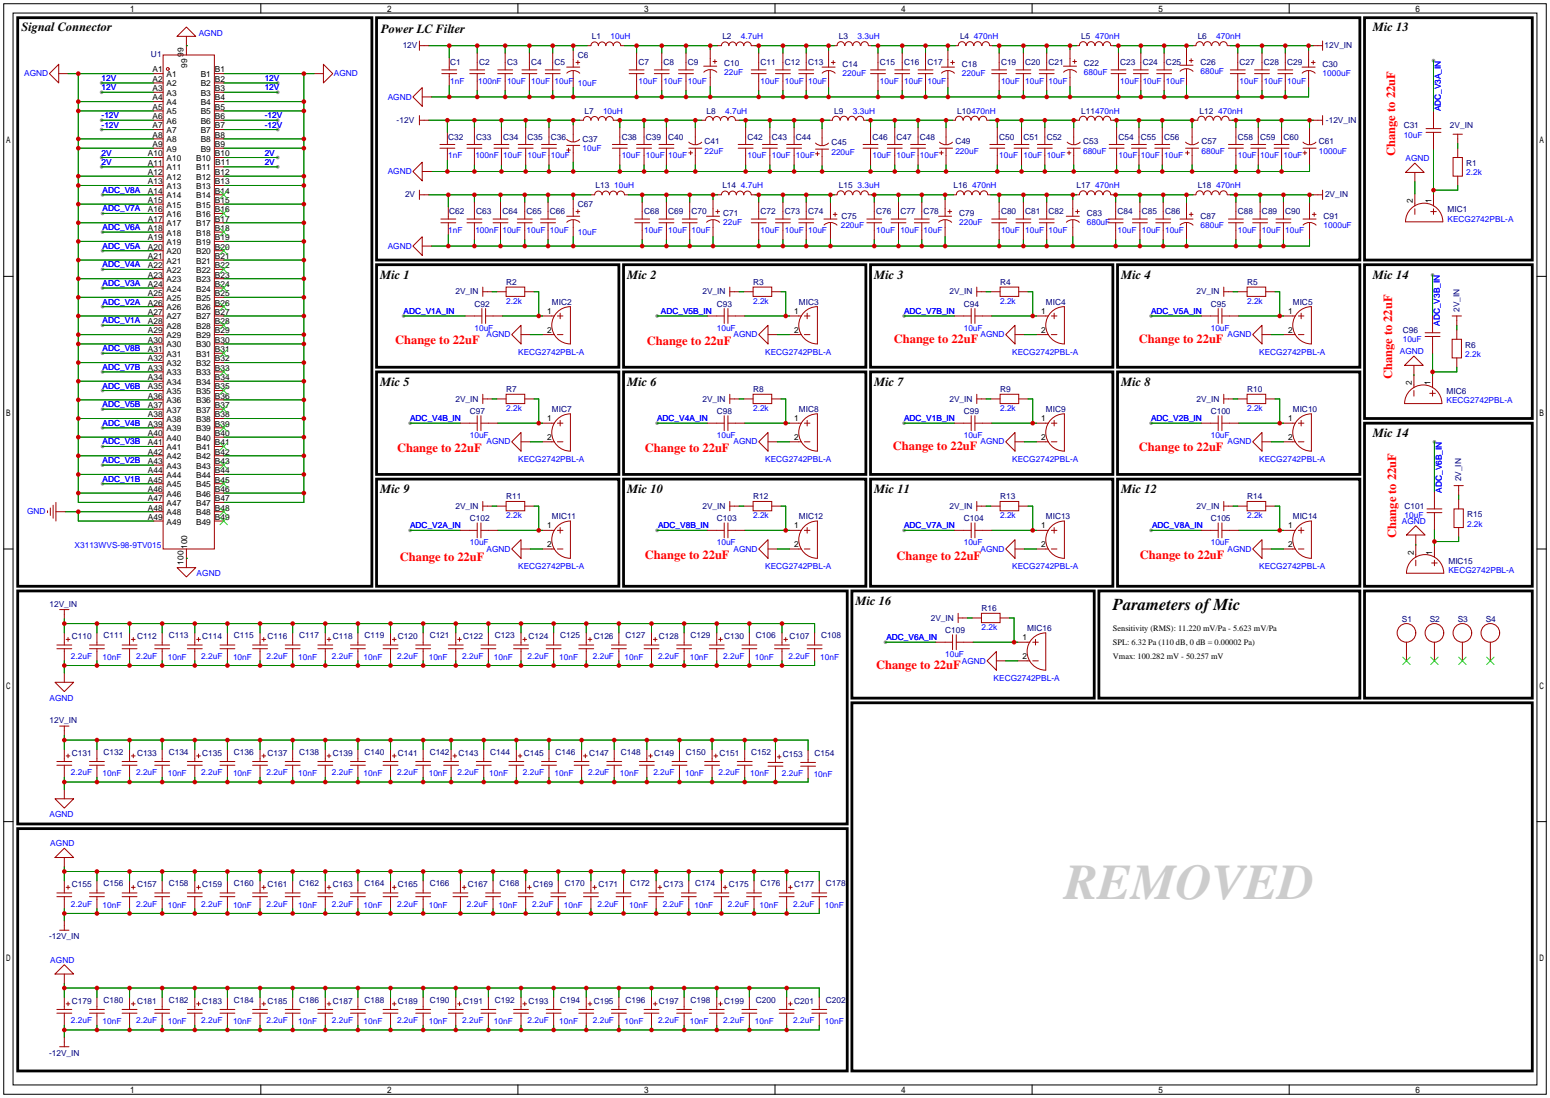
[picture p34: page 1]

Change to 22uF Change to 22uF Change to 22uF

Sensitivity (RMS): 11.220 mV/Pa - 5.623 mV/Pa
SPL: 6.32 Pa (110 dB, 0 dB = 0.00002 Pa)
Vmax: 100.282 mV - 50.257 mV

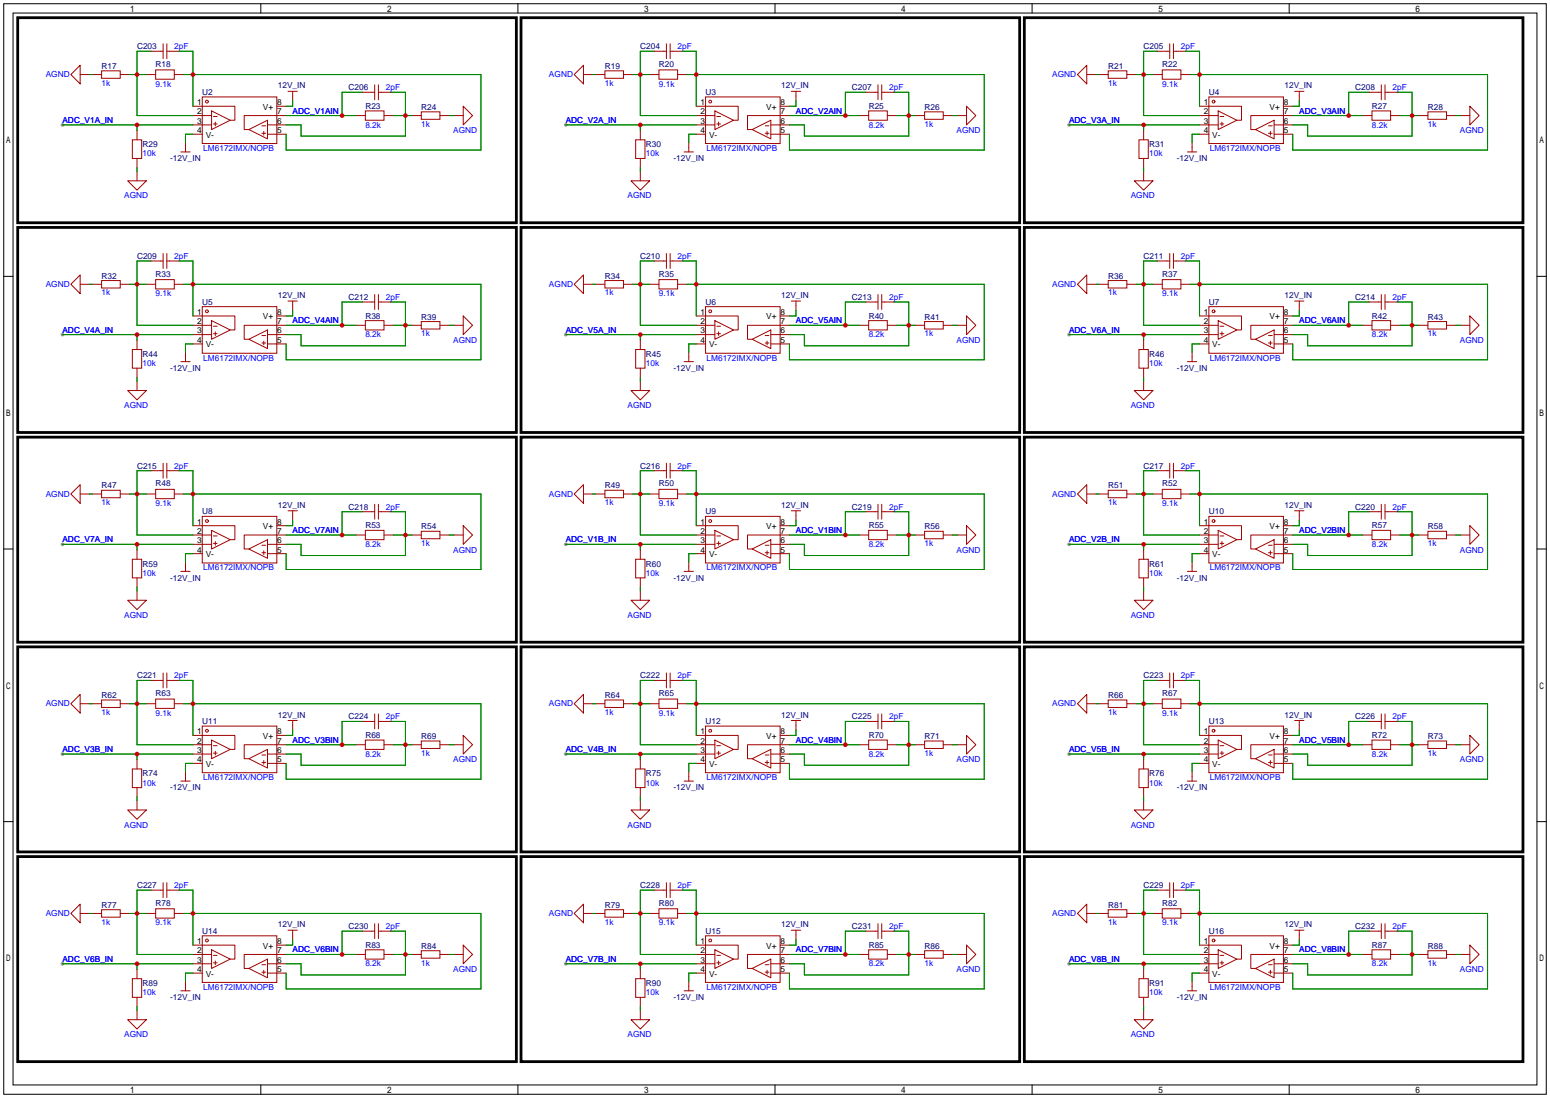
[picture p35: page 2]

# REMOVED

### DNP

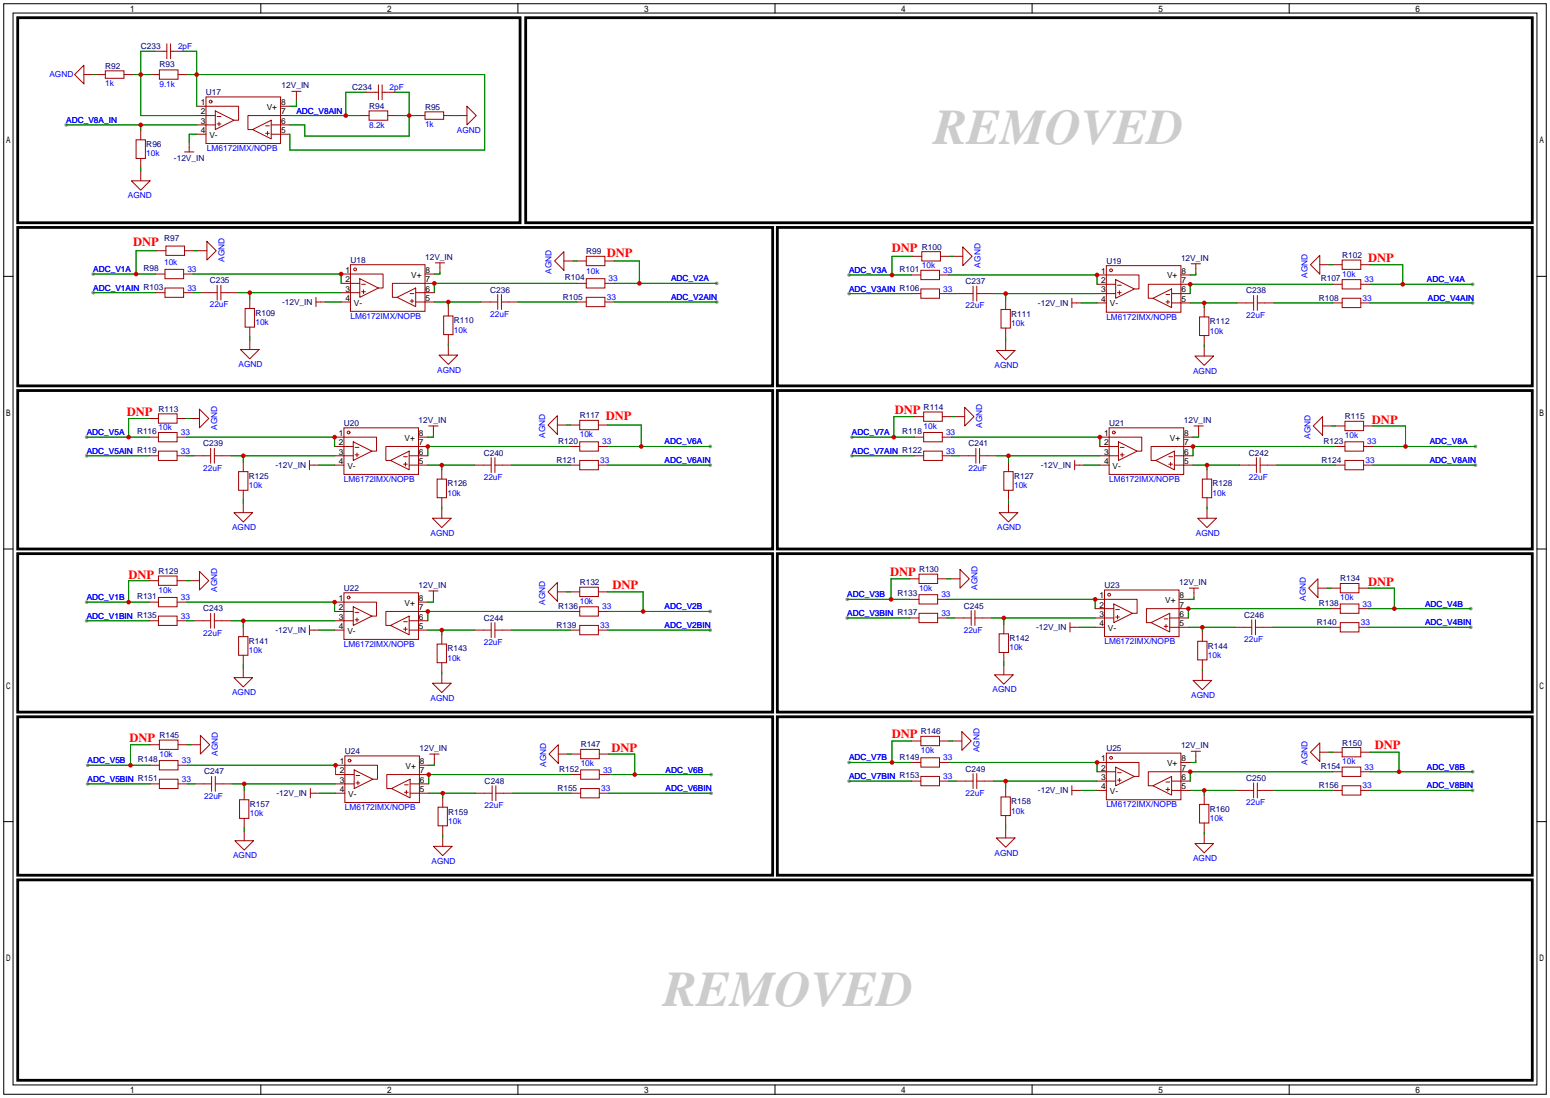
[picture p36: page 3]
