ShixuanLiu9527/VUPRS-Support/(commit log)

2025-08-14 添加XDMA
2025-08-14 添加eigen
2025-08-30 FPGA笔记更新, Linux内核没学完
2025-09-01 完成 AD7606 驱动模块
2025-09-01 修改verilog代码
2025-09-08 增加FPGA代码功能, 增加Xilinx JTAG烧录软件
2025-09-10 ADC驱动调试V1.0
2025-09-12 修改FPGA代码, 成功正确采样
2025-09-13 修改状态机逻辑
2025-09-15 修改bug, 优化时序
2025-09-16 添加采样模块
2025-09-21 增加说明, 增加时钟发生模块
2025-09-21 添加说明
2025-09-24 add AXI-Lite & AXI-Stream interface to ADC module
2025-09-26 Add AXI-Stream ADC Controller IP for VUPRS FPGA
2025-10-02 添加Block Design设计
2025-10-03 更新文档
2025-10-04 修改AXI-Stream TLAST信号的生成时间
2025-10-04 修改user guide
2025-10-04 修改latex
2025-10-04 增加采集板插入接口
2025-10-04 修改readme
2025-10-04 修改doc
2025-10-05 添加驱动使用说明
2025-10-05 增加说明文档
2025-10-06 完成Block design
2025-10-06 增加链接
2025-10-08 增加通道顺序与数据帧说明
2025-10-08 修改数据帧格式, 增加CRC8校验
2025-10-09 AXI-Stream Master增加CRC校验
2025-10-13 修正DDR3引脚映射文件, 修正文档
2025-10-13 修改文档, 添加新的地址映射
2025-10-17 增加复位寄存器
2025-10-20 修复FPGA代码bug, 修复DMA S2MM_LENGTH寄存器
2025-12-04 添加麦克风阵列设计原理图
2026-02-18 链接vuprs-fpga
2026-02-22 修正参数
2026-02-22 修正以太网参数
2026-02-23 优化readme
2026-02-23 增加仓库说明
2026-03-16 保存新版本
2026-08-17 更新仓库文档以及部分资料
2026-08-17 删除.vscode
2026-08-17 修改项目主页描述
2026-08-17 增加图示
